Jamie215/DualIMU_Goniometer/README.md

# Dual-IMU Knee Goniometer

Two Arduino Nano 33 BLE Rev2 boards (one on the thigh, one on the shank) measure
knee flexion angle. Each board runs a 6-DOF orientation filter; the **shank
board (peripheral)** streams its state to the **thigh board (central)** over a wired UART
link, and the central merges both segments and streams them to a PC, where
`knee_collector_uart.py` computes and logs the knee angle.

The design goal is a **placement-independent** angle: you should not have to mount
the boards in a precise, repeatable orientation.

## Getting started

**Using the device (collecting data).** Download `KneeGoniometerGUI.exe` (Windows)
from the [latest release](https://github.com/Jamie215/DualIMU_Goniometer/releases/latest)
and follow the SOP, which covers building the device, flashing the boards, placing
the sensors and running a session:
[`docs/SOP_Build_and_Use.docx`](docs/SOP_Build_and_Use.docx) (master copy;
a read-only Markdown mirror is [`docs/SOP_Build_and_Use.md`](docs/SOP_Build_and_Use.md)).
No Python is needed.

**Changing the code.**
- GUI / angle math (Python): set up Python as in [Live GUI](#live-gui-knee_guipy),
  then publish a new exe as in [Releasing an updated GUI](#releasing-an-updated-gui).
- Firmware: see [Quick start](#quick-start-developers-command-line) and the
  [wire protocol](#data-format--wire-protocol); reflash **both** boards after a change.

**Background.** [`docs/Project_Handover.md`](docs/Project_Handover.md) (current state,
open issues and next steps; why it is built this way; research directions), and the
Preliminary Stationary Test Report
(`analysis/static_test/Static_Stability_Test_Report.docx`).

---

## Hardware & wiring

- 2× **Arduino Nano 33 BLE Rev2** (onboard **BMI270** accel+gyro; BMM150
  magnetometer is present but **unused**).
- UART between the boards (`Serial1`, **115200 baud**), **both directions wired**:
  the peripheral streams data to the central, and the central sends a keepalive to the
  peripheral so it only runs during a collection (see "Collect-on-demand" below):

  ```
  Peripheral TX (D1)  ->  Central RX (D0)     # shank data stream
  Central TX (D1) ->  Peripheral RX (D0)      # keepalive / start-stop
  Peripheral GND     <->  Central GND
  ```
- Central connects to the PC over USB.
- Mount convention used in testing: board long axis along the limb long axis,
  USB port toward the hip, one board above and one below the knee. Exact rotation
  / position does **not** need to match between boards (see "How it works").

---

## Quick start (developers, command line)

For data collection, use the GUI (see [Getting started](#getting-started)); this
section is the command-line route used during development.

1. **Flash** `central_imu/central_imu.ino` to the thigh board and
   `peripheral_imu/peripheral_imu.ino` to the shank board (Arduino IDE, board = "Arduino
   Nano 33 BLE", library **Arduino_BMI270_BMM150**). Confirm each reports
   *Done uploading*.
2. When a collection starts (the central's USB port is opened by the collector or
   GUI), **keep both boards still for ~4 s** — they measure gyro bias then. The
   central prints `# central gyro bias dps: ...`.
3. **Sanity check** the link and signal:
   ```
   python knee_collector_uart.py --port /dev/ttyACM0 --monitor
   ```
   `thigh` / `shank` are the gyro-fused gravity tilts the angle uses; `accel` is
   a filter-free raw-accel cross-check; `rel` is the yaw-prone relative-quaternion
   angle (drift probe); `valid%` / `rtt` show link health.
4. **Collect**:
   ```
   python knee_collector_uart.py --port /dev/ttyACM0
   ```
   - Hold the leg **straight and still** (~2 s) to zero.
   - Do a few slow reps that bend **both knee and hip** (sit-to-stands /
     marching) so each board tilts enough to learn its "forward" direction.
   - The signed knee angle is printed live and logged to `knee_log.csv`.

`--selftest` (no hardware) runs the full math test suite.

---

## Live GUI (`knee_gui.py`)

For a testing / proof-of-concept session there is a Tkinter + Matplotlib front
end over the same angle math. It is the easiest way to run a collection. Most
users run it as the Windows executable (see [below](#windows-executable)); to run
or change it from source:

```
pip install -r requirements.txt
python knee_gui.py                 # scan for the central port and go
python knee_gui.py --simulate      # no hardware: synthetic flexing-knee source
python knee_gui.py --selftest      # headless: sample-gate + source logic
```

What it adds over the CLI:

- **Port scan** — probes each serial port for valid `D` lines and picks the
  central automatically. (Only the central is on USB; a dead peripheral link shows up
  as a low shank-valid %, not a second port.)
- **One row per sample** — every data line from the central becomes exactly one
  CSV row and plot point: nothing repeated, nothing skipped. `t_session_s` comes
  from the board's own clock (true measurement timing, ~20 ms apart at 50 Hz);
  `t_wall_iso` is when the PC received the line. (Earlier versions wrote rows on a
  PC-side 20 ms timer, which repeated ~20 % of samples and skipped others.)
- **Obvious calibration** — a colour-coded banner drives the phases with a live
  countdown: amber **CALIBRATING - HOLD STILL** (straight leg) → amber
  **CALIBRATING - SWEEP** (bend knee + hip, with a live shank-tilt readout) →
  green **RUNNING** (phases `zeroing` / `sweep` / `running` in the CSV).
- **Plots** — knee angle (primary), the two segment inclinations it is built
  from, and the link RTT. While collecting they show a rolling window; when you
  **Stop collecting** they switch to the **entire session** (not just the last
  window) and a pan/zoom/save toolbar becomes usable so you can inspect the
  frozen trace (Home returns to the full-session view).
- **Dropout mode (switchable live)** —
  **Fill** forward-fills short gaps and draws a continuous line;
  **Gap** keeps only real samples and draws discrete points, so dropouts appear
  as visible gaps. The CSV records which samples were real in either mode.
- **Session-based collect / stop / reset** — each **Calibrate & collect** starts
  a fresh session: a new timestamped CSV, a cleared plot, and calibration from
  scratch. **Stop collecting** ends it, freezes the display on the last data,
  and returns to idle. Collecting again is a clean reset — you recalibrate, and
  a new file is written. (There is no pause/resume: the display only rolls while
  a session is actually collecting.)
- **Errors** — a red banner names the exact fault (no data / wrong firmware /
  dead peripheral link), using the same diagnosis as the CLI.
- **Auto-save** — each session auto-saves to `knee_YYYYMMDD_HHMMSS.csv`;
  **Save copy…** relocates the current one. A crash never loses a session.

The CSV is a superset of the CLI log (adds wall-clock and session time, the two
inclinations, and the `phase` / `fill_mode` columns), so existing analysis still
reads it.

### Windows executable

Download `KneeGoniometerGUI.exe` from the
[latest release](https://github.com/Jamie215/DualIMU_Goniometer/releases/latest).
No Python install is needed. CSVs and diag logs are written to the **current working
directory** (relative paths), which is the exe's own folder when you
double-click it, so keep the exe somewhere writable (Desktop, Documents, a
data folder), not `Program Files`. The exe is unsigned, so Windows SmartScreen
may warn on first run: **More info -> Run anyway**.

### Releasing an updated GUI

The exe is built and published by `.github/workflows/release.yml` whenever a
version tag (`v*`) is pushed: on a Windows runner it installs `requirements.txt`
and PyInstaller, runs `python knee_gui.py --selftest` (a failure stops the
release), builds the exe, and creates a GitHub Release with it attached. After
changing `knee_gui.py` or `knee_collector_uart.py` (which the GUI imports):

1. **Check locally** on your branch:
   ```
   python knee_collector_uart.py --selftest
   python knee_gui.py --selftest
   python knee_gui.py --simulate
   ```
   and, ideally, one real session with the hardware.
2. **Merge into `main`** (pull request).
3. **Pick the next version.** Never reuse a tag; `git tag --list` shows the ones
   used. Bug fix: `v1.0.1`; new feature: `v1.1.0`; a change that breaks existing
   users or analysis (e.g. CSV columns change): `v2.0.0`.
4. **Tag `main` and push the tag:**
   ```
   git checkout main
   git pull
   git tag v1.0.1
   git push origin v1.0.1
   ```
5. **Watch the Actions tab** (a few minutes). When the run is green, the
   [Releases](https://github.com/Jamie215/DualIMU_Goniometer/releases) page shows
   the new version with `KneeGoniometerGUI.exe`. Edit its notes to say what
   changed in plain words.
6. **Tell users** to download the new exe and replace their old file (SOP §4.3).

If the run fails, no release is created. Fix the problem on `main`, then push a
new tag (e.g. `v1.0.2`), or delete the failed tag and push it again:
`git push --delete origin v1.0.1`, `git tag -d v1.0.1`, then repeat step 4.

The firmware is not part of the exe. If you change the `.ino` files, reflash
**both** boards (SOP §4.2) and say so in the release notes.

"Run workflow" on the Actions tab (manual run) only builds the exe as a
downloadable artifact for testing; it does not create a release.

To build locally instead (on Windows):

```
pip install -r requirements.txt pyinstaller
pyinstaller --onefile --windowed --name KneeGoniometerGUI knee_gui.py
```

The exe is written to `dist\KneeGoniometerGUI.exe`.

---

## How it works (the math)

Each IMU estimates orientation with a **6-DOF Mahony filter** (accelerometer +
gyroscope, no magnetometer — robust to nearby metal). There is **one** angle
method, chosen for reliability across both slow and brisk motion.

### Gravity-referenced sagittal inclinometer

The reliable, observable quantity in a 6-DOF filter is the **direction of gravity
in each board's own frame**: the accelerometer pins it (so it doesn't drift in
tilt) and it's invariant to heading (so the 6-DOF yaw, which *does* drift, never
enters). We read that gravity direction from the **fused quaternion** — so the
gyro carries it smoothly through fast motion instead of the reading collapsing
whenever the limb accelerates — then build a signed segment inclination and take
the difference. Here is the full derivation.

Notation: quaternions are `(w, x, y, z)`, Hamilton convention; `q*` is the
conjugate; world "up" is `ẑ = (0, 0, 1)`. Each board `i ∈ {thigh, shank}`
reports a unit orientation quaternion `q_i` (board → world).

**1. Gravity in the board frame.** Rotate world-up into the board's own frame
with the inverse orientation, and keep the vector part:

```
g_i = vec( q_i* ⊗ (0, ẑ) ⊗ q_i ),   then normalize      # unit vector
```

`g_i` is the direction of gravity as the board feels it. It uses only the tilt
part of `q_i`, so it is **drift-free** (the accelerometer fixes tilt) and
**yaw-invariant** (rotating `q_i` about vertical leaves `g_i` unchanged). Code:
`gravity_in_board()`.

**2. Zero reference `d_i` (static-hold calibration).** With the leg held straight
and still, average `g_i` over the hold window. `d_i` is the segment's long axis
as seen in the board frame — the direction gravity points at 0°:

```
d_i = normalize( Σ g_i(t)  over the still hold )         # code: average_gravity()
```

**3. Forward direction `f_i` (functional-sweep calibration).** During the slow
reps, the part of `g_i` **perpendicular to `d_i`** is the direction the segment
tilts toward as it flexes. Remove the `d_i` component, sign-align the samples (the
limb sweeps consistently one way from extension), and sum:

```
g⊥ = g_i − (g_i · d_i) d_i                                # in-plane component
f_i = normalize( Σ sign(g⊥ · ref) · g⊥ )                  # code: estimate_forward()
```

Samples that tilt less than `SWEEP_MIN_ANGLE_DEG` are ignored so IMU noise around
the zero pose can't define the direction. `d_i` and `f_i` are orthonormal by
construction and together span that segment's **sagittal plane** in its own frame.
If a segment barely moved, `f_i` is undefined and that segment contributes 0.

**4. Signed segment inclination.** The tilt of the segment is the angle of `g_i`
within the `(d_i, f_i)` plane — the four-quadrant angle from the zero axis `d_i`
toward forward `f_i`:

```
incl_i = atan2( g_i · f_i , g_i · d_i )   [rad]           # code: sagittal_inclination()
```

At the zero pose `g_i = d_i`, so `g_i · f_i = 0`, `g_i · d_i = 1`, and
`incl_i = 0`. `atan2` gives a continuous signed angle through the full range
(flexion positive, hyperextension negative), with no ±90° wrap.

**5. Knee angle.** The joint angle is the difference of the two segment
inclinations:

```
knee = incl_thigh − incl_shank        (converted to degrees)   # code: gravity_knee_angle()
```

*Why the difference is placement-independent (sketch):* for planar flexion the
segment rotates about a fixed axis, so `g_i(t)` traces a circular arc that lies
entirely in one plane of the board frame — and a rigid mount `B_i` maps that plane
to a fixed plane spanned by `d_i, f_i`. `incl_i` reads the arc angle inside that
plane, and the fixed mount rotation only rotated the plane, not the angle within
it. So any constant mount `B_i` cancels exactly (the `--selftest` proves this
against random `B_thigh`, `B_shank`).

Because every quantity is an angle between two vectors in the **same** board
frame, the result is immune to:
- **Position** on the limb (orientation sensors don't measure location);
- **Constant mounting rotation**, incl. **rotation of the board about the leg's
  long axis** (any fixed mount rotation cancels);
- **6-DOF yaw drift** (gravity-in-board is invariant to heading about vertical).

Validated in `--selftest` against random mounts, a turning shared heading,
independent per-board yaw drift (exact recovery), and a full flex-to-130°-and-back
sweep (the signed angle retraces identically — no stuck zeros on return).

**Trade-off:** gravity gives only **2 of the 3 rotational DOF** — it is blind to
rotation about the vertical (gravity) axis. So this method measures the
**sagittal-plane** component of the angle — ideal for upright knee flexion
(standing ROM, gait, sit-to-stand). It under-reads motion well out of the vertical
plane (e.g. lying down with large hip rotation). Note this is an *observability*
limit, not a mounting one: a fixed mount tilt cancels for planar motion (step 5),
but tilt combined with out-of-sagittal-plane motion steers part of the true joint
rotation into the unobservable yaw direction, where gravity cannot see it — the
one case a gravity-only method fundamentally cannot recover.

### What "0°" means (relative, not absolute)

The angle is **relative to the pose held during the static zero** — whatever
posture you hold at calibration becomes 0°, regardless of the true anatomical
geometry. A leg that is anatomically straight but sits at a residual angle
(recurvatum, or a patient who can't fully extend) still reads **0°** here. Every
reading is therefore a **change from the zeroing pose**, not an absolute
femur-vs-tibia angle.

This is exactly right for what a session actually measures — **ROM (max − min),
rep counting, gait, and movement quality** are all difference-based, so the
reference cancels and the choice of zero doesn't matter. What it does **not**
give:

- an **absolute clinical angle** (e.g. "flexion contracture of 10°"), which is a
  statement about the zero itself;
- comparability **across sessions** zeroed on different poses, since each
  session's 0° may correspond to a different real angle.

Recovering a true anatomical zero would require an **external reference** — a
manual goniometer on the leg, or a fixture that physically defines full
extension. The two IMUs alone cannot observe it: the method is deliberately blind
to how each board is mounted relative to the bone (that blindness is exactly what
makes it placement-independent), so there is no anatomical landmark in the data
for it to find absolute zero from. For this proof of concept we accept the
relative zero and rely on the difference-based readings above.

### Why the quaternion (not the raw accelerometer)

Gravity-in-board is taken from the Mahony quaternion, which fuses accel + gyro,
rather than from the bare accelerometer. During any brisk movement the raw
accelerometer measures gravity **plus linear acceleration**, so its direction is
momentarily wrong — the cause of erratic readings (and apparent zeros) right after
swinging back from a high angle. The fused quaternion lets the **gyro carry** the
fast part while the accelerometer keeps the tilt drift-free, so the angle stays
smooth *and* drift-free. The firmware trusts the accelerometer with a **soft
gate** (`ACC_TRUST_FULL_G` → `ACC_TRUST_ZERO_G`): full weight when near-static,
ramping to zero as `|accel|` leaves 1 g — always applying *some* correction, so
the estimate never runs fully open-loop and then snaps back.

(The raw accelerometer is still streamed and shown as a filter-free cross-check in
`--monitor`.)

---

## Commands

```
python knee_collector_uart.py --port PORT [options]

  --monitor                 live bring-up check (gyro-fused vs raw-accel tilts)
  --raw                     dump raw serial lines with field counts, then exit
  --cal-seconds N           straight-and-still zero hold (default 2)
  --sweep-seconds N         calibration-motion window (default 6)
  --out FILE                CSV path (default knee_log.csv)
  --selftest                run the math self-tests (no hardware)
```

CSV columns: `t_thigh_us, thigh_qw..qz, shank_qw..qz, knee_angle_deg, status,
rtt_us` (status ∈ `zeroing / sweep / valid / filled / missing`).

---

## Data format / wire protocol

**Peripheral → central stream (binary, 30 bytes/packet, fixed 50 Hz):**
```
[0]      0xAA header
[1..16]  float q0..q3   (little-endian, w,x,y,z)
[17..28] float ax,ay,az (little-endian, g, handedness-corrected)
[29]     XOR checksum of bytes [1..28]
```
**Collect-on-demand & rate.** The boards run their IMUs only while a collection is
active, so nothing runs unobserved. "Active" = the central's **USB port is open** (the
collector, GUI, or even the Serial Monitor holds it) — no PC-side command needed. On
start the central calibrates + seeds fresh and forwards a **keepalive** to the peripheral
(over `Central TX -> Peripheral RX`); the peripheral calibrates and streams while the keepalive
arrives and idles when it stops (port closed / central reset). Both boards emit at a
fixed **50 Hz** (down from ~104 Hz) for generous link + USB timing margin; the peripheral
also self-heals a bad low-rate sensor start by re-initializing (no manual reset).
It also guards against a failing sensor: a sample with a hung read (> 50 ms),
an impossible |accel| (< 0.25 g or > 4 g), or a rotation rate over 1000 °/s while
the accelerometer reads ~1 g is never fed to the filter and is sent as the all-zero
quaternion (a gap, not a wrong angle); every re-init resets the filter's integral
term; and if no good sample arrives for 5 s the peripheral reboots itself. LED:
central lit = collecting; peripheral fast blink = active, slow blink = idle, solid = sensor
stalled, 3 flashes = boot.

The shank board **streams** its packets while active; it is not polled. The central is
a passive listener on the data line: each loop it drains its UART buffer, **resyncs on the `0xAA`
header**, validates the checksum, and keeps the freshest complete packet — it never
blocks on the peripheral. A lost/extra byte fails one checksum and resyncs on the next
header, so a glitch costs one packet, never a lasting desync. The central timestamps
each packet on its own clock when parsed; if the freshest packet is older than
`SHANK_STALE_US` (30 ms) the shank is reported invalid (zeros) for the collector to
forward-fill. The line's last field is that packet's **age** in µs — small is
healthy, large (or a run of invalids) means the peripheral has stalled.

**Central → PC line (text, 18 fields):**
```
D,t_thigh_us,tw,tx,ty,tz,tax,tay,taz,t_shank_recv_us,sw,sx,sy,sz,sax,say,saz,age_us
```
When the freshest shank packet is stale/absent, `t_shank_recv_us` and the shank
fields are `0`; the collector marks such samples invalid (and short gaps are
forward-filled). `age_us` is the freshest shank packet's age (the CSV keeps the
`rtt_us` column name for continuity — same units, a link-health number).

**Diagnostics (`DIAG 1` in both sketches).** The peripheral also sends a once-a-second
health frame on the same link (`0xAB` header, packed `PDiag` struct, XOR checksum;
the struct must match in both files). The central relays it to the PC as
`# PDIAG k=v ...` and adds its own `# CDIAG k=v ...` line (emit interval, IMU-read
and print durations, parser counters, UART backlog, IMU health). `knee_gui.py`
saves every `#` line to `knee_diag_<timestamp>.log`, and
`analysis/diagnostics/parse_diag.py <log>` turns it into per-second CSVs and a
per-minute summary. Flash **both** boards with a diagnostic build: an older central
doesn't know the `0xAB` frame and can lose a shank packet a second resyncing.
The GUI CSV also carries the raw accelerometer of each board
(`thigh_ax..az`, `shank_ax..az`, g), which shows physical movement independent of
the orientation filter.

---

## Findings / debugging log

The path to a stable signal turned up several non-obvious issues, all worth
recording:

1. **The Arduino library returns a left-handed sensor frame.**
   `Arduino_BMI270_BMM150` maps `x=-sensor.y, y=-sensor.x, z=sensor.z` for both
   accel and gyro — **determinant −1, a reflection**. A quaternion filter needs a
   right-handed frame (angular velocity is an axial vector), so the gyro's
   rotation sense was mirrored relative to the accelerometer and the filter
   wandered. **Fix:** negate `x` of accel *and* gyro to restore det +1.

2. **Startup gyro-bias calibration can cause runaway.** Averaging the gyro at
   boot to subtract bias is only valid if the board is still; if it's moving, the
   subtracted "bias" is a large false rate that can exceed the filter's
   correction gain and make the estimate diverge. **Fix:** discard the measured
   bias if any axis exceeds `BIAS_SANITY_DPS` (3 °/s), and keep the board still
   at startup.

3. **6-DOF has no shared heading.** Each board's yaw is unobservable and drifts
   independently, so the *relative-quaternion* angle drifts even on a rigid,
   stationary rig. The **gravity-referenced** method avoids this because
   gravity-in-board is yaw-invariant. (A rigid-ruler test — both boards on one
   ruler — was the key diagnostic: the true relative angle must be constant, so
   any drift is pure estimation error.)

4. **"Gravity from the quaternion" inherits a bad quaternion.** *While the filter
   was still wandering* (before finding #1 was fixed), both paths failed together,
   and reading gravity straight from the **raw accelerometer** was the decisive
   static fix. Once the handedness reflection was corrected the quaternion tracks
   properly, and the raw accelerometer's own weakness (finding #5) made it the
   worse default — see finding #7.

5. **Fast motion corrupts the accel-as-gravity assumption.** During any brisk
   movement the accelerometer reads gravity **plus linear acceleration**, so its
   direction is momentarily wrong. In the filter this is handled by **accel
   trust gating**; a bare-accelerometer angle has no such protection and reads
   erratically (apparent zeros/overshoot) right after swinging back from a high
   angle.

6. **Shank dropouts that grow over a session — traced in three steps.** The symptom
   was shank samples going invalid more and more as a session ran, with the link
   round-trip climbing alongside. Diagnosing it took three passes, each of which
   ruled something out:

   - **Framing desync.** The board-to-board reply was read as a fixed 30 bytes with
     no header resync, so one lost/extra byte on the async link shifted every
     following packet by one, and the misalignment was self-sustaining. **Fix:**
     resync on the `0xAA` header + validate the checksum, so a glitch costs one
     packet, not a run. Also returned `Serial1` from `460800` to **115200** for ~4×
     the per-byte timing margin (a 30-byte packet at 104 Hz needs only ~25 kbaud, so
     the lower rate costs nothing and drifts far less as the boards self-heat). An
     earlier pass had *raised* the rate to `460800` to shrink time-on-wire, which
     masked the desync but added the thermal fragility.
   - **Too-tight response window.** With framing fixed, `valid%` rose to ~93% but
     the remaining drops showed the request round-trip hitting the *full* timeout —
     the peripheral producing nothing in time, not corrupt bytes. Root cause: the peripheral
     only answered a poll between chunks of its own loop, and the mbed RTOS adds
     sporadic multi-ms stalls, so a reply could arrive after any fixed deadline.
   - **The real fix — stream instead of poll.** Widening the deadline is an arms
     race (and every stall stalls the central). Instead the peripheral now **streams** its
     packet continuously and the central reads the freshest one already in its UART
     buffer, never blocking. A peripheral stall no longer drops a sample — it just ages
     the newest packet; if that age exceeds `SHANK_STALE_US` (30 ms) the sample is
     marked invalid and the collector forward-fills it. This decouples the central's
     rate from the peripheral's latency entirely. Line field 18 is now the packet **age**
     (`age_us`); a large age or a run of invalids localizes a stalled/dead peripheral.

7. **Consolidated to one reliable method: gravity-in-board from the fused
   quaternion.** The project had accumulated four selectable behaviors
   (`--method gravity|quat` × `--gravity-source accel|quat`) that masked each
   other's failure modes. With the filter now correct (finding #1), the
   quaternion-sourced gravity direction is both **smooth through fast motion**
   (gyro carries) and **drift-free in tilt** (accel corrects) — strictly better
   than the raw-accel default, whose motion corruption (finding #5) produced the
   erratic post-flexion readings. The alternate modes and the yaw-prone
   relative-quaternion swing-twist method were removed. The hard accel gate was
   also replaced with a **soft gate** (`ACC_TRUST_FULL_G` 0.10 g →
   `ACC_TRUST_ZERO_G` 0.60 g): trust ramps down with `|accel|` instead of cutting
   off, so the filter is always partly corrected during motion and never runs
   open-loop and then snaps back on the way out.

Validation so far: on a rigid ruler, thigh and shank tilts agree; placing the
shank board at a right angle to the thigh board reads ~90°.

> Note: an earlier exploration added a full **magnetometer (9-DOF)** path with
> runtime PC-side calibration and an automatic BMM150→BMI270 axis solver. It was
> removed in favor of the simpler, metal-robust 6-DOF + gravity approach, but it
> lives in the branch history if absolute-heading stability is ever needed.

---

## Known limitations & next steps

- **Sagittal plane only** — see the trade-off above.
- **Validate against a protractor** — a preliminary 45°/90° rig check read
  45.0° / 89.0° (see the stationary test report); a controlled, repeated test
  with **both** nodes swept during calibration is still needed.
- **Faulty board** — one board's BMI270 fails after 20–40 min; replace it before
  further testing (see `docs/Project_Handover.md`).
- **Fast dynamic capture** — the gyro-fused gravity direction carries through
  motion; if very fast reps still lag or overshoot, tune the filter (`TWO_KP`)
  and the soft gate (`ACC_TRUST_FULL_G` / `ACC_TRUST_ZERO_G`) on both boards.
- **Per-session re-zero** handles any slow accelerometer/bias offset; hold the
  leg straight and still at the start of each capture.
- **Dropouts** — watch the run summary (`valid / filled / missing`); if the link
  is flaky over long wires, drop `Serial1` to 230400 on both boards.

For larger research directions being weighed — magnetometer fusion and the
absolute-vs-relative angle question, absolute (anatomical) angle via functional
calibration, wireless (BLE) links, and scaling to multiple nodes / joints — see the appendices of
[`docs/Project_Handover.md`](docs/Project_Handover.md).

---

## Files

```
central_imu/central_imu.ino          thigh board: 6-DOF filter, reads peripheral stream, streams to PC
peripheral_imu/peripheral_imu.ino    shank board: 6-DOF filter, streams packets over UART
knee_collector_uart.py               PC collector: calibration, angle math, CSV, --selftest
knee_gui.py                          live GUI over the same math: guided calibration, plots, auto-save
requirements.txt                     Python dependencies (collection, GUI, analysis)
DualIMU_Goniometer.stl               3-D printable board case (base + lid)
analysis/static_test/                stationary test scripts, figures, report (.docx) and FINDINGS.md
analysis/diagnostics/parse_diag.py   diag log (# CDIAG / # PDIAG lines) -> CSVs + per-minute summary
docs/SOP_Build_and_Use.docx          SOP: build, set up and run the device (Word master; .md mirror)
docs/Project_Handover.md             handover: state and next steps, design decisions, research directions (+ .docx)
docs/build_docs.sh                   regenerates Project_Handover.docx from its Markdown (pandoc)
docs/images/                         figures for the SOP mirror (sop/) and the handover document (handover/, SVG sources)
.github/workflows/release.yml        builds and releases KneeGoniometerGUI.exe on a v* tag
```
