Jamie215/DualIMU_Goniometer/analysis/static_test/report_stability.png

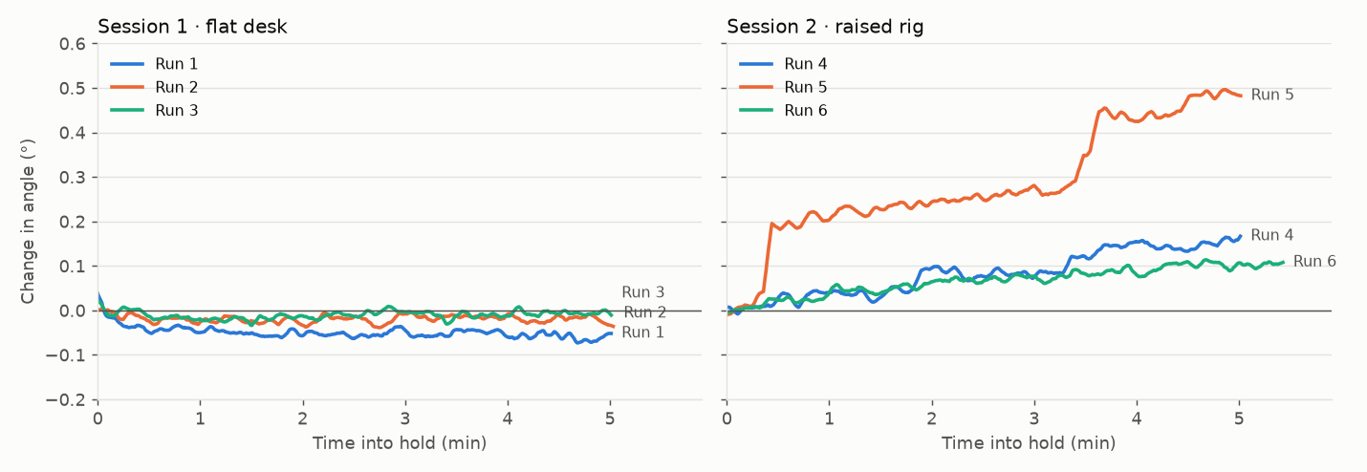
analysis/static_test/report_stability.png
