Jamie215/DualIMU_Goniometer/DualIMU_Goniometer.step

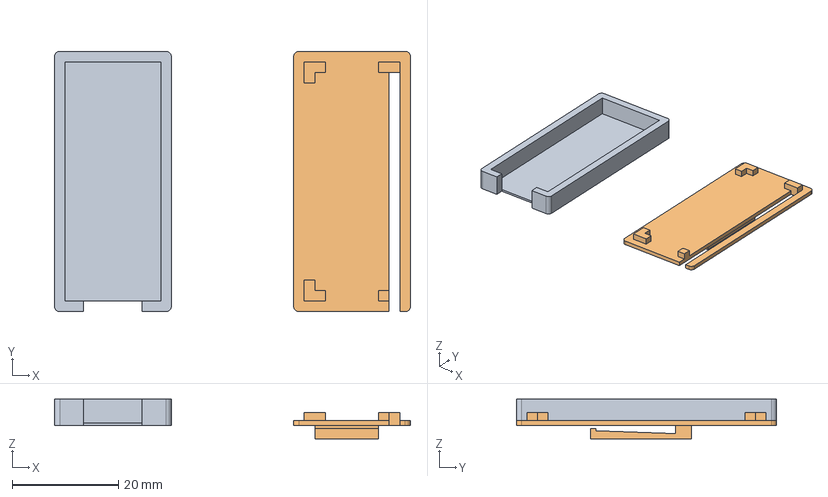
[picture p6: CAD file, 2026-10-29]
DualIMU_Goniometer.step
67.0 x 49.0 x 7.50 mm
