Jamie215/DualIMU_Goniometer/(list of files, cad)

Other CAD files:
DualIMU_Goniometer.stl
