Jamie215/DualIMU_Goniometer/analysis/static_test/Static_Stability_Test_Report.docx

# Dual-IMU Goniometer Project

Preliminary Stationary Test Report

This document records the stationary testing of the dual-IMU goniometer prototype: what was tested, how, what the results showed, which problems turned up along the way and how they were addressed.

# What We are Testing

- Stability: Given there is no range of motion, does the measured angle also stay unchanged? This test covers short-term jitter, slow drift, and data quality over sessions.
- Endurance: How long can the data be collected without data quality dropping?
- Preliminary angle check: Do fixed 45° and 90° rigs read close to nominal? This is a preliminary inspection only, as the environment did not allow a fully controlled setup.

# Setup

Hardware: Two Arduino Nano 33 BLE Rev2 boards (BMI270 IMU) connected by a wired UART link; both nodes were powered over USB.

| Session 1 (Runs 1–3) | Session 2 (Runs 4–6) | Endurance Runs 1–3 | Angle Rig (45°, 90°)
Thigh node | Taped to the desk | Taped to a raised rig (1 cm higher) | Taped to the rig | On the flat upper segment
Shank node | Taped to a ruler | Taped to a flat surface (~5 cm apart) | Taped to a ruler | On the angled lower segment
Duration | ~5 min per run | ~5–5.5 min per run | 24–60 min, unattended | ~20–25 s hold each

Procedure (every run):

1. Zeroing (2 seconds): Both nodes held still. This pose becomes 0°.
2. Calibration sweep (6 seconds): The shank node was rotated and returned, so the software learns the direction it bends in.
3. Collection: For testing purposes, the nodes were stationary through this phase. For the angle rig, the shank segment was set at the rig angle and held.

Note: The first 20 seconds (time taken for calibration and settling) are excluded from the stability analysis.

# Findings

## 1. Sessions 1 & 2: Near-Zero Angle Stability

Change in angle during each 5-minute hold

Figure 1: Change in the measured angle during each stationary hold (5 s rolling average), relative to the first 10 s of the hold

Table 1: Stationary hold results for Sessions 1 and 2

Run | Resting angle | Jitter (SD) | Change over the Hold | Drift
1 | −0.30° | 0.015° | −0.06° | −0.005 °/min
2 | −0.02° | 0.011° | −0.03° | −0.0003 °/min
3 | +0.03° | 0.011° | −0.01° | +0.001 °/min
4 | +6.38° | 0.016°∗ | +0.16° | +0.033 °/min
5 | −1.27° | 0.047°∗ | +0.49° (two steps) | +0.082 °/min
6 | −0.84° | 0.012°∗ | +0.11° | +0.019 °/min

∗ Note 1: The resting angle is where the node came to rest after the calibration sweep, relative to where it was zeroed. It reflects placement and stays constant during the hold.

∗ Note 2: For Session 2, the SD is calculated with the slow trend removed, so it measures jitter rather than creep.

Table 2: Allan deviation (how much averages over a time window τ differ from one window to the next)

Averaging Window τ | Session 1 | Session 2
0.1 s | 0.003° | 0.003°
1 s | 0.005° | 0.005–0.007°
60 s | 0.004–0.007° | — (rig creep dominates)

- Session 1
  - The reading moved by 0.06° at most over 5 minutes, and the drift direction flipped between runs, indicating noise rather than drift.
  - The Allan deviation shows that the noise did not grow over time.
- Session 2
  - The reading crept by 0.1–0.5°.
  - Run 5 had two sudden steps. The thigh node, which is not part of the angle calculation, moved at the same time, so the creep most likely came from the setup settling. In a later run, the raw accelerometer confirmed that a similar creep was the ruler physically tilting.

## 2. Endurance Test

Three unattended endurance runs of 24–60 minutes checked how long data can be collected before its quality drops.

Table 3: Endurance runs

Run | Faulty board’s role | Length | Clean data until (board uptime) | Outcome
1 | Shank | 38 min | 20.4 min | Shank sensor degraded, then stopped at 26.3 min; no shank data afterwards
2 | Shank | 24 min | 24.8 min | Shank sensor failed abruptly; the board rebooted itself, but the sensor stayed dead
3 (roles swapped) | Thigh | 60 min | 37.8 min | Thigh sensor stopped at 47.3 min and sampling fell to ~5 Hz

∗ Note 3: Board uptime is the board’s own clock since power-up. The cause of the faults is covered in Issues Found (2).

Table 4: Angle stability during the clean part of the endurance runs

Run | Window | Length | Jitter (SD) | Drift | Range of 5 s averages
1 | 3–18 min | 15 min | 0.016° | −0.001 °/min | 0.10°
3∗ | 3–36 min | 33 min | 0.018° | −0.001 °/min | 0.09°

∗ Note 4: In endurance run 3, the angle came only from the healthy shank board, since the thigh node is not part of the angle (see Limitations). The window ends before the thigh node’s sensor fault affected the data flow.

- Endurance
  - On the faulty board, data quality dropped after 20–38 minutes in every run, while the other board ran for over an hour without a fault in either role.
  - The drop in quality after long sessions is traced to that board (see Issues Found (2)).
- Stability over time
  - Over the clean windows, the angle drifted about −0.001 °/min (about 0.04° over 33 minutes), with the same jitter as the 5-minute holds.

## 3. Preliminary Angle Assessment: 45° and 90°

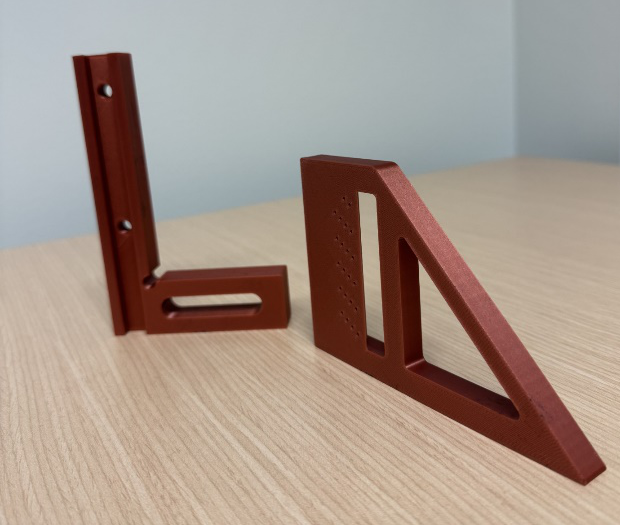
[picture p12: figure]

Figure 2: Angled rigs used during the test (left: upper segment, right: lower segment)

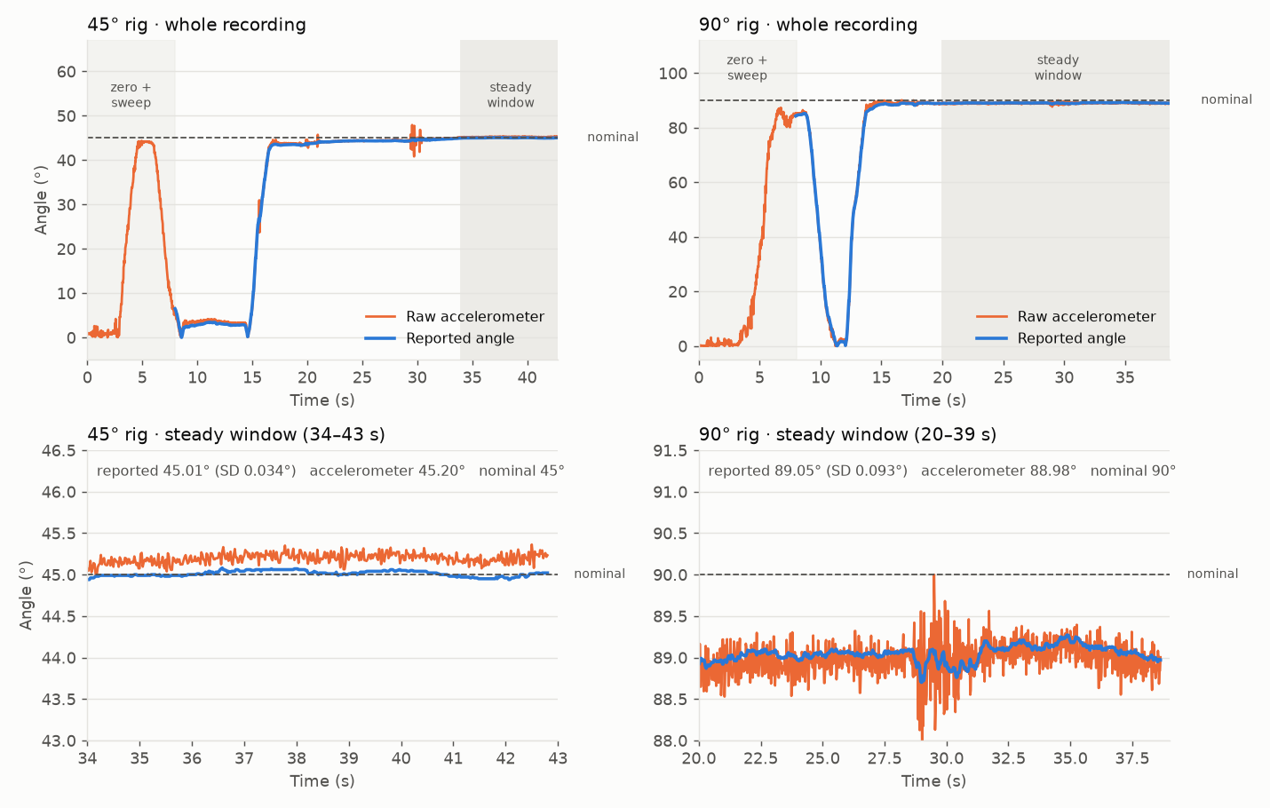
[picture p13: figure]

Figure 3: Static angle collected over time (45° and 90°)

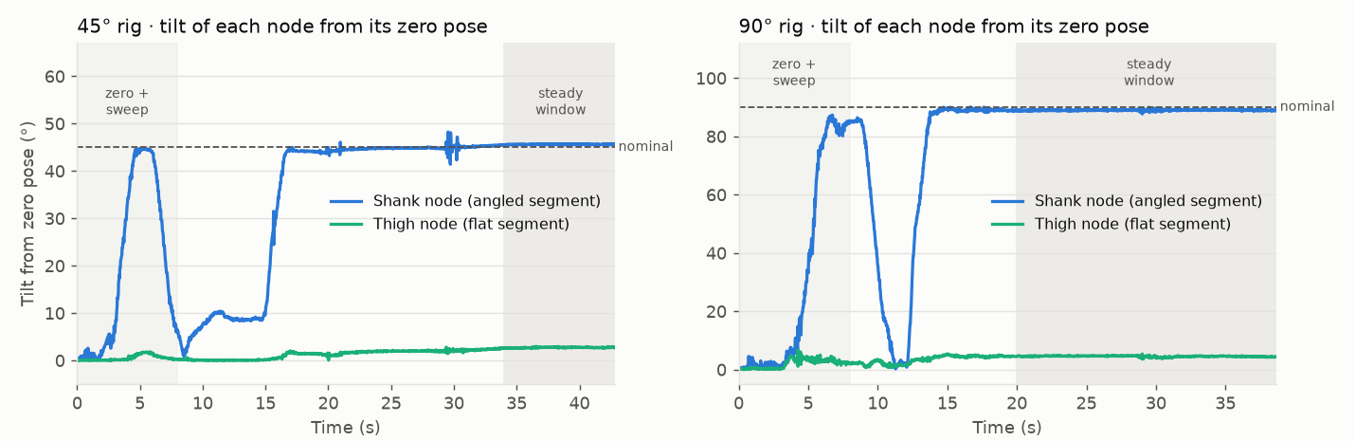
[picture p14: figure]

Figure 4: Tilt of each node over time (45° and 90°)

∗ Note 5: These are from raw accelerometers, measured from its own zero pose, which is different from how the angle (range of motion) is calculated in the software. This is to inspect if the there was any movement at the node level.

Table 5: Static angle assessment (45° and 90°)

Rig | Reading (steady part) | Diff from nominal | Jitter (SD) | Raw-accelerometer check
45° | 45.0° | 0.0° | 0.034° | 45.2°
90° | 89.0° | 1.0° | 0.093° | 89.0°

- Shank node tilt is measured correctly
  - The raw accelerometer, which does not depend on the filter or the calibration, agrees with the reported angle within about 0.2°. The calibration therefore learned the right bending direction, and a 90° hold is as steady as a 0° hold.
- Reference (thigh) node shifted during placement
  - The thigh node shifted 2.7° on the 45° rig and 4.5° on the 90° rig. It tilted about as much across the bending plane as along it, which suggests the board shifted on its segment rather than the segment rotating.
  - The software ignores this node because it did not tilt during calibration. If the upper segment stayed flat, as intended, the readings above stand; if the segment itself moved, the true angle between the segments could differ by up to ~2–3°.

## 4. Other Notable Findings

- Heading drift does not affect the angle
  - Each sensor’s heading (compass direction) drifted by 0.2–5 °/min, and the angle ignored it in every run, by design.
- Calibration copes with an imperfect setup
  - In Session 2, the shank node was zeroed 4–15° off level, and the sweep was shorter (~55°) and in the opposite direction. Calibration still worked and the reading was just as steady.
  - These holds stayed within the swept range. By design, the angle depends only on the sweep’s direction, not on how far it went; the rig tests held slightly beyond their sweeps (45.0° vs 44.3°, 89.0° vs 85.5°) with no loss of agreement, but holding well beyond a short sweep was not tested.
- Link reliability
  - All samples were valid in the six short runs (Session 1 & 2). The endurance runs had no checksum failures while the boards were healthy, apart from 2 at start-up in one run.

# Issues Found

## 1. Sample Rate was ~40 Hz (Fixed)

Table 6: Sample rate before and after the fixes

| Before | After the fixes
Central board’s cycle | ~23 ms (~43.5 Hz) | 20.0 ms (50 Hz)
Printing each data line | ~11.7 ms (~36 separate prints) | ~1.0–1.8 ms (one write)
Unique samples in the CSV | ~40.5 per second | ~50 per second
CSV rows repeating the previous sample | 19–20 % | 0 %

- Cause
  - The central board ran slow: each output cycle spent ~10.7 ms reading its IMU and ~11.7 ms printing the data line as ~36 separate blocking prints.
  - The interface wrote rows on its own 20 ms timer, which ticks unevenly on Windows, so rows repeated some samples and skipped others.
- Fixes
  - The central board builds each line in memory and sends it with one write.
  - The interface now writes exactly one row per received sample, timed by the board’s own clock.
  - Both were confirmed in the endurance runs: 50 rows/s, 0 duplicate rows, rows 19.9 ms apart.
- Effect on the results above
  - None for the stationary results: with duplicates removed, every run’s mean, SD and drift are identical to within 0.0002°. The fix matters for movement data.

## 2. Poor Data Quality in Long Sessions (Traced to One Faulty Board)

During the endurance runs, data quality from one node dropped after 20–38 minutes, and its sensor stopped after 25–47 minutes. The evidence points to a hardware fault on one of the two Arduino boards as the most likely cause.

Table 7: Sensor fault timeline for the faulty board

Endurance run | Faulty board’s role | Sensor trouble started | Sensor stopped
1 | Shank | 20.4 min | 26.3 min
2 | Shank | 24.8 min (abrupt) | 24.8 min; still dead after the automatic reboot
3 (roles swapped) | Thigh | 6.5 min (missed updates); 37.8 min (hung reads) | 47.3 min

- What happened
  - Individual sensor reads started hanging for ~190–200 ms and returning garbage while the board sat still (accelerometer up to 4.4 g, gyro up to 2400 °/s), which made the angle swing by tens of degrees.
  - A few minutes later the sensor stopped producing data entirely. Restarting the sensor, or rebooting the board, did not bring it back.
- How it was traced
  - Swapping the boards’ firmware roles moved the fault with the board: the failing board failed again as the thigh node, while the other board ran the shank role for over an hour with 0 bad readings.
  - Across all runs, the other board never had a sensor problem in either role.
- Mitigation added
  - The shank firmware rejects implausible sensor samples and records them as gaps instead of wrong angles, resets its filter after each sensor restart, and reboots the board if the sensor produces nothing usable for 5 seconds.
  - During the endurance test #2, the guard caught the bad readings which triggered the reboot. However, the sensor stayed dead, which is further evidence that the fault was in the hardware.

# Limitations

- Only one node was exercised in the angle
  - The angle is the difference between the two nodes’ tilts, but the software only uses a node’s tilt if it moved at least 5° during the calibration sweep. For the tests conducted in this report, only the shank node was swept, so the thigh node was treated as fixed and the angle came from the shank node alone.
  - The thigh node’s own data shows it was just as stable, but its contribution to the angle was not tested.
- Accuracy needs to be further assessed in a fully controlled environment
  - The 45°/90° check was one placement each, and the thigh node shifted 2.7–4.5° during placement.
- Jitter is limited by the log format
  - Angles are logged to 0.01°, so the ~0.01° jitter is an upper bound; the true sensor noise can be lower.

# Conclusions and Next Steps

Across short stationary holds, endurance tests, and a preliminary 45°/90° rig check, the prototype held a very stable angle on healthy hardware (≈0.01–0.02° jitter, ≈−0.001 °/min drift) and read within about 1° of both rig angles. Testing also revealed a sample-rate shortfall, now fixed to a true 50 Hz, and traced the loss of data quality in long sessions to a faulty sensor on one Arduino board, with firmware added to contain it. Accuracy remains preliminary, but the results support moving on to both-node calibration and dynamic range-of-motion testing once the faulty board is replaced.

Next steps include first replace the faulty board and repeat a one-hour stationary run on two healthy boards to establish a clean baseline. From there, both nodes should be swept during calibration so that the angle uses both sensors, and the reference node and its cable should be fixed firmly so they cannot shift. If a more precise rig is available, repeating the 0°, 45° and 90° placements several times each would turn the angle check into an accuracy figure. Logging angles to more decimal places would reveal the true noise floor, and with the sample rate and CSV timing now sound, the work can move on to dynamic range-of-motion testing.
