Jamie215/DualIMU_Goniometer/analysis/static_test/angle_rig_nodes.png

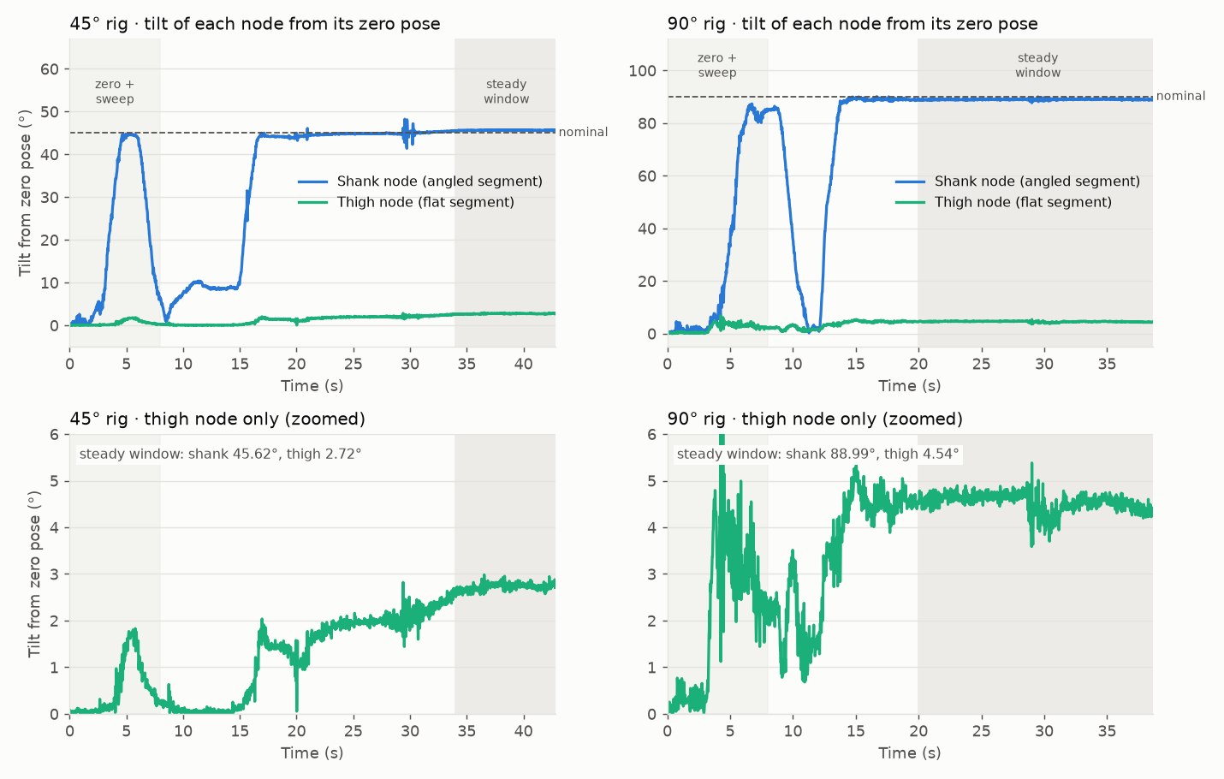
analysis/static_test/angle_rig_nodes.png
