Jamie215/DualIMU_Goniometer/central_imu/central_imu.ino

/*
 * KNEE ANGLE - CENTRAL (thigh)  [UART, 6-DOF quaternion + raw gravity]
 * Board: Arduino Nano 33 BLE Rev2  (onboard BMI270; magnetometer unused)
 *
 * Streams, per segment: an orientation quaternion (6-DOF Mahony) AND the raw
 * accelerometer vector. The collector derives the knee angle from the gravity
 * direction in each board's own frame, taken from the QUATERNION (gyro-fused,
 * so it stays smooth through fast motion and drift-free in tilt). The raw accel
 * is still sent for the filter-free cross-check in --monitor.
 *
 * IMPORTANT axis note: Arduino_BMI270_BMM150 returns accel/gyro as
 *   x=-sensor.y, y=-sensor.x, z=sensor.z  (determinant -1, a REFLECTION -> a
 * left-handed frame). A quaternion filter needs a right-handed frame, so we
 * negate x of accel AND gyro to restore det +1. Without this the gyro's rotation
 * sense is mirrored vs the accel and the filter wanders.
 *
 * The shank board STREAMS its state at a fixed 50 Hz; this board is a passive
 * listener. Each loop it drains its UART buffer, keeping the freshest complete
 * packet, and emits a merged PC line at 50 Hz -- it never blocks waiting on the
 * peripheral, so a peripheral stall just ages the last packet instead of dropping a sample.
 * The lower rate (down from ~104 Hz) leaves generous link + USB timing margin.
 *
 * Peripheral stream packet (30 bytes):
 *   [0] 0xAA header
 *   [1..16]  float q0..q3        (LE, w,x,y,z)
 *   [17..28] float ax,ay,az      (LE, g, handedness-corrected)
 *   [29] XOR checksum of [1..28]
 *
 * PC line (18 fields):
 *   D,t_thigh_us,tw,tx,ty,tz,tax,tay,taz,t_shank_recv_us,sw,sx,sy,sz,sax,say,saz,age_us
 * The last field is the freshest shank packet's AGE in us (0 if none yet). When the
 * newest packet is older than SHANK_STALE_US the shank fields and its timestamp are
 * 0, so the collector marks the sample invalid and forward-fills it.
 *
 * Collect-on-demand: the boards run their IMUs only while a collection is active
 * (this board's USB port is open). The central forwards a keepalive to the peripheral so
 * both run in lockstep and both idle when the port closes -- nothing runs unobserved.
 *
 * Wiring (BOTH directions needed): Peripheral TX(D1)->Central RX(D0) for the stream, and
 * Central TX(D1)->Peripheral RX(D0) for the keepalive, plus GND<->GND.
 *
 * DIAGNOSTICS (DIAG = 1): once a second this board prints a '# CDIAG ...' line
 * (its own loop/emit timing, link-parser counters, thigh IMU health) and relays
 * the peripheral's once-a-second health frame as '# PDIAG ...'. Both are
 * space-separated key=value lines; the collector and GUI ignore '#' lines for
 * data, and the GUI saves them to a knee_diag_*.log file next to the CSVs.
 * Peripheral health frame (sizeof(PDiag) + 2 bytes):
 *   [0] 0xAB header, [1..N] PDiag struct (LE, packed), [N+1] XOR of [1..N]
 * Flash BOTH boards with a diagnostic build: an older central doesn't know the
 * 0xAB frame and may lose a shank packet each second to resyncing.
 */

#include "Arduino_BMI270_BMM150.h"

const float TWO_KP = 2.0f * 0.5f;
const float TWO_KI = 2.0f * 0.02f;
float integralFBx = 0.0f, integralFBy = 0.0f, integralFBz = 0.0f;
float q0 = 1.0f, q1 = 0.0f, q2 = 0.0f, q3 = 0.0f;
unsigned long lastMicros = 0;

// Resting gyro bias (deg/s), measured at startup. Guarded: if the board wasn't
// still (measured bias too large), we discard it rather than inject a false rate.
float gyroBias[3] = {0.0f, 0.0f, 0.0f};
const float BIAS_SANITY_DPS = 3.0f;

// Accelerometer-as-gravity trust, as a function of how far |accel| is from 1 g.
// A hard on/off gate let the filter run gyro-only through a fast move, so it
// drifted and then snapped back on the way out (the "wrong reading right after
// returning from a big angle" symptom). Instead we SOFT-gate: full accel trust
// when nearly static, ramping linearly to zero as linear acceleration grows, so
// some drift correction is always applied while the gyro carries the fast part.
const float ACC_TRUST_FULL_G = 0.10f;   // within this of 1 g -> trust accel fully
const float ACC_TRUST_ZERO_G = 0.60f;   // beyond this -> gyro only (no correction)

// The shank streams a packet every ~20 ms (50 Hz). We treat the newest packet as a
// live shank sample until it is older than this; past it, the peripheral is presumed
// stalled and the sample is emitted invalid for the collector to fill. 30 ms is ~1.5
// packet intervals: it absorbs normal phase jitter without lying about the data
// (shank orientation barely moves in 30 ms), while flagging a dead peripheral promptly.
const unsigned long SHANK_STALE_US = 30000;

// Fixed PC output rate (the 50 Hz baseline). The filters still run at the sensor's
// full rate for smoothness, but we emit ONE merged line every EMIT_PERIOD_US. A
// lower collection rate halves link + USB pressure and leaves generous timing
// margin, and 50 Hz is far more than knee ROM needs (it's resampled PC-side anyway).
const unsigned long EMIT_PERIOD_US = 20000;   // 50 Hz
unsigned long lastEmitUs = 0;
float thighAx = 0, thighAy = 0, thighAz = 1;  // latest thigh raw accel, cached for the emit

// --------------------------------------------------------------------------- //
// Diagnostics. Set DIAG to 0 to drop the '#' lines (the 0xAB frame is still
// parsed, harmlessly, if a diagnostic peripheral is attached).
// --------------------------------------------------------------------------- //
#define DIAG 1
const unsigned long DIAG_PERIOD_MS = 1000;

// Peripheral health frame -- MUST match peripheral_imu.ino byte for byte.
struct __attribute__((packed)) PDiag {
  uint32_t upMs;          // peripheral millis()
  uint16_t pktsSent;      // shank packets sent this window
  uint16_t keepalives;    // 'S' bytes received this window
  uint16_t rateReinits;   // cumulative low-rate watchdog re-inits
  uint16_t stallReinits;  // cumulative stall watchdog re-inits
  uint16_t beginFails;    // cumulative IMU.begin() failures
  uint16_t lastReinitMs;  // duration of the most recent re-init
  uint32_t loopMaxUs;     // longest loop() pass this window
  uint32_t sendLateMaxUs; // worst lateness of a send vs its 20 ms due time
  uint32_t sendLateAvgUs; // mean lateness
  int16_t  gyroMaxDps;    // max |gyro| (bias-corrected), deg/s
  int16_t  gyroAvgDps10;  // mean |gyro|, 0.1 deg/s
  int16_t  accMinMg;      // min |accel|, milli-g
  int16_t  accMaxMg;      // max |accel|, milli-g
  int16_t  integDps10;    // |Mahony integral term| now, 0.1 deg/s
  int16_t  biasDps100;    // largest axis of the last bias measurement, 0.01 deg/s
  uint16_t badSamples;    // samples rejected by the sensor-fault guard this window
  uint16_t readMaxMs;     // slowest accel+gyro read this window, ms
  uint8_t  biasOk;        // 1 = last bias measurement accepted (board was still)
  uint8_t  active;
};
const uint8_t HDR_SHANK = 0xAA;
const uint8_t HDR_PDIAG = 0xAB;
const int SHANK_FRAME_LEN = 30;
const int PDIAG_FRAME_LEN = sizeof(PDiag) + 2;
PDiag pdiag;
bool pdiagFresh = false;

// Central-side window counters (reset every DIAG_PERIOD_MS).
unsigned long dEmits = 0, dImuMiss = 0, dStale = 0;
unsigned long dEmitMin = 0xFFFFFFFF, dEmitMax = 0, dEmitSum = 0, dEmitN = 0;
unsigned long dImuMax = 0, dImuSum = 0, dPrintMax = 0, dPrintSum = 0;
unsigned long dLoopGapMax = 0, dPumpGapMax = 0, dSerChkMax = 0;
unsigned long dFramesOk = 0, dCsFail = 0, dSkipped = 0, dPdiagOk = 0;
int dRxMax = 0;
float dGyroMax = 0, dAccMin = 99, dAccMax = 0;
unsigned long lastEmitTnow = 0, lastLoopUs = 0, lastPumpUs = 0, lastDiagMs = 0;
unsigned long lastDiagWriteUs = 0;   // how long the previous diag line's single write took
// A diag write stalls the loop once a second; don't let that pollute the gap and
// interval maxima it is trying to measure (each flag is cleared where it's used).
bool skipLoopGap = false, skipPumpGap = false, skipEmitIv = false;

// Collect-on-demand. The boards run the IMUs only while a collection is active,
// not free-running from power. "Active" = the USB port is open (a host -- the
// collector, the GUI, even the Serial Monitor -- has it open), detected via
// `Serial`. On start we calibrate + seed fresh; while active we forward a keepalive
// to the peripheral so it runs in lockstep; on port close everything idles.
bool collecting = false;
unsigned long lastKeepAliveMs = 0;
const unsigned long KEEPALIVE_MS = 200;       // how often to poke the peripheral while active

// Read sensors with the reflection fixed (negate x -> right-handed frame).
inline void readAccel(float &ax, float &ay, float &az) {
  IMU.readAcceleration(ax, ay, az); ax = -ax;
}
inline void readGyro(float &gx, float &gy, float &gz) {
  IMU.readGyroscope(gx, gy, gz); gx = -gx;
}

void calibrateGyroBias() {
  const int N = 300;
  float sx = 0, sy = 0, sz = 0;
  int got = 0;
  unsigned long t0 = millis();
  while (got < N && millis() - t0 < 4000) {
    if (IMU.gyroscopeAvailable()) {
      float gx, gy, gz;
      readGyro(gx, gy, gz);
      sx += gx; sy += gy; sz += gz; got++;
    }
  }
  if (got > 0) {
    float bx = sx / got, by = sy / got, bz = sz / got;
    float m = max(fabs(bx), max(fabs(by), fabs(bz)));
    if (m <= BIAS_SANITY_DPS) {          // trust only if the board was still
      gyroBias[0] = bx; gyroBias[1] = by; gyroBias[2] = bz;
    }  // else leave 0 (a moving startup would otherwise destabilize the filter)
  }
}

void seedFromAccel(float ax, float ay, float az) {
  float roll  = atan2(ay, az);
  float pitch = atan2(-ax, sqrt(ay * ay + az * az));
  float cr = cos(roll * 0.5f),  sr = sin(roll * 0.5f);
  float cp = cos(pitch * 0.5f), sp = sin(pitch * 0.5f);
  q0 = cr * cp; q1 = sr * cp; q2 = cr * sp; q3 = -sr * sp;
}

void mahonyUpdate(float gx, float gy, float gz,
                  float ax, float ay, float az, float dt) {
  float amag = sqrt(ax * ax + ay * ay + az * az);
  if (amag > 1e-6f) {
    // Soft gate: 1.0 near static, ramping to 0.0 as |accel| leaves 1 g.
    float err = fabs(amag - 1.0f);
    float trust;
    if (err <= ACC_TRUST_FULL_G)      trust = 1.0f;
    else if (err >= ACC_TRUST_ZERO_G) trust = 0.0f;
    else trust = (ACC_TRUST_ZERO_G - err) / (ACC_TRUST_ZERO_G - ACC_TRUST_FULL_G);

    if (trust > 0.0f) {
      float recipNorm = 1.0f / amag;
      ax *= recipNorm; ay *= recipNorm; az *= recipNorm;

      float halfvx = q1 * q3 - q0 * q2;
      float halfvy = q0 * q1 + q2 * q3;
      float halfvz = q0 * q0 - 0.5f + q3 * q3;

      float halfex = (ay * halfvz - az * halfvy) * trust;
      float halfey = (az * halfvx - ax * halfvz) * trust;
      float halfez = (ax * halfvy - ay * halfvx) * trust;

      if (TWO_KI > 0.0f) {
        integralFBx += TWO_KI * halfex * dt;
        integralFBy += TWO_KI * halfey * dt;
        integralFBz += TWO_KI * halfez * dt;
        gx += integralFBx; gy += integralFBy; gz += integralFBz;
      }
      gx += TWO_KP * halfex; gy += TWO_KP * halfey; gz += TWO_KP * halfez;
    }
  }

  gx *= 0.5f * dt; gy *= 0.5f * dt; gz *= 0.5f * dt;
  float qa = q0, qb = q1, qc = q2;
  q0 += (-qb * gx - qc * gy - q3 * gz);
  q1 += ( qa * gx + qc * gz - q3 * gy);
  q2 += ( qa * gy - qb * gz + q3 * gx);
  q3 += ( qa * gz + qb * gy - qc * gx);

  float recipNorm = 1.0f / sqrt(q0 * q0 + q1 * q1 + q2 * q2 + q3 * q3);
  q0 *= recipNorm; q1 *= recipNorm; q2 *= recipNorm; q3 *= recipNorm;
}

void setup() {
  Serial.begin(115200);
  Serial1.begin(115200);        // board-to-board link (must match peripheral). 115200,
                                // not 460800: a 30-byte packet at 50 Hz needs only
                                // ~12 kbaud, and the two boards clock this async link
                                // off independent oscillators that drift apart as they
                                // warm -- the lower rate keeps ample timing margin so
                                // framing errors don't grow over a session.
  while (!Serial) { ; }

  pinMode(LED_BUILTIN, OUTPUT);
  digitalWrite(LED_BUILTIN, LOW);

  if (!IMU.begin()) {
    Serial.println("ERR,IMU init failed");
    while (1) { ; }
  }
  Serial.println("# CENTRAL fw: gated-50hz-onewrite-diag (collect while USB open; shank keepalive-gated)");
  Serial.println("# CENTRAL cols: D,t_thigh_us,tw,tx,ty,tz,tax,tay,taz,"
                 "t_shank_recv_us,sw,sx,sy,sz,sax,say,saz,age_us");
  lastMicros = micros();
  // No IMU calibration here -- it happens fresh in startCollecting(), so each
  // session gets a clean bias and the sensor isn't run while nothing is observing.
}

// Begin a collection: tell the peripheral to start (so it calibrates in parallel),
// then calibrate + seed this board. Held-still assumption applies here, not at boot.
void startCollecting() {
  Serial1.write('S');                  // wake the peripheral (it calibrates in parallel)
  Serial.println("# collecting: calibrating, hold still ~3 s");
  calibrateGyroBias();
  Serial.print("# central gyro bias dps: ");
  Serial.print(gyroBias[0], 3); Serial.print(',');
  Serial.print(gyroBias[1], 3); Serial.print(',');
  Serial.println(gyroBias[2], 3);

  unsigned long t0 = millis();
  while (!IMU.accelerationAvailable() && millis() - t0 < 2000) { ; }
  if (IMU.accelerationAvailable()) {
    float ax, ay, az;
    readAccel(ax, ay, az);
    seedFromAccel(ax, ay, az);
  }
  lastMicros = micros();
  lastEmitUs = micros();
  collecting = true;
  digitalWrite(LED_BUILTIN, HIGH);     // lit = collecting
}

void stopCollecting() {
  Serial1.write('X');                  // tell the peripheral to idle
  collecting = false;
  digitalWrite(LED_BUILTIN, LOW);      // dark = idle
}

// A Print target that accumulates one output line in RAM, so the line can be
// formatted exactly as Serial.print() would format it and then sent in one write.
struct LineBuf : public Print {
  char buf[256];
  size_t len = 0;
  void reset() { len = 0; }
  size_t write(uint8_t c) override {
    if (len >= sizeof(buf)) return 0;   // never overflow; a D line is ~150 bytes
    buf[len++] = (char)c;
    return 1;
  }
  using Print::write;
};
LineBuf line;

// Freshest shank state received from the stream, plus when (central clock) it was
// parsed. shankRecvUs == 0 until the first good packet arrives.
float shankQ[4] = {0, 0, 0, 0};
float shankA[3] = {0, 0, 0};
unsigned long shankRecvUs = 0;

// Persistent frame-assembly state for the free-running stream. We resync on the
// 0xAA header and validate the XOR checksum, so a lost/extra byte costs one frame
// (checksum fail -> drop -> resync to the next header), never a lasting desync.
uint8_t rxBuf[64];
int rxHave = 0;
int rxWant = 0;

// Non-blocking: consume every byte currently buffered, updating the cache with the
// LAST complete, checksum-good packet. Called often so the UART buffer never backs
// up; whatever the peripheral streamed while we were busy is waiting here, not lost.
void pumpShankStream() {
  unsigned long now = micros();
  if (lastPumpUs != 0 && !skipPumpGap && now - lastPumpUs > dPumpGapMax) dPumpGapMax = now - lastPumpUs;
  lastPumpUs = now;
  skipPumpGap = false;
  int avail = Serial1.available();
  if (avail > dRxMax) dRxMax = avail;         // backlog: near the buffer size = overflow risk

  while (Serial1.available()) {
    uint8_t b = Serial1.read();
    if (rxHave == 0) {                        // hunting for a header
      if (b == HDR_SHANK)      rxWant = SHANK_FRAME_LEN;
      else if (b == HDR_PDIAG) rxWant = PDIAG_FRAME_LEN;
      else { dSkipped++; continue; }
      rxBuf[0] = b; rxHave = 1;
    } else {
      rxBuf[rxHave++] = b;
      if (rxHave == rxWant) {
        uint8_t cs = 0;
        for (int i = 1; i <= rxWant - 2; i++) cs ^= rxBuf[i];
        if (cs != rxBuf[rxWant - 1]) {
          dCsFail++;                          // bad frame: drop, resync on next header
        } else if (rxBuf[0] == HDR_SHANK) {   // good shank frame -> update cache
          memcpy(shankQ, &rxBuf[1], 16);
          memcpy(shankA, &rxBuf[17], 12);
          shankRecvUs = micros();
          dFramesOk++;
        } else {                              // good peripheral health frame
          memcpy(&pdiag, &rxBuf[1], sizeof(PDiag));
          pdiagFresh = true;
          dPdiagOk++;
        }
        rxHave = 0;
      }
    }
  }
}

#if DIAG
// One buffered write per line (integers only, so no float printf needed). Its
// own duration is reported on the NEXT line as diag_write_us -- a direct
// comparison against print_us, the many-small-prints cost of each data line.
char diagBuf[400];
void diagWrite(int n) {
  if (n <= 0) return;
  if (n > (int)sizeof(diagBuf)) n = sizeof(diagBuf);
  unsigned long t0 = micros();
  Serial.write((const uint8_t *)diagBuf, n);
  lastDiagWriteUs = micros() - t0;
  skipLoopGap = skipPumpGap = skipEmitIv = true;
}

void diagReport() {
  unsigned long up = millis();
  int n = snprintf(diagBuf, sizeof(diagBuf),
    "# CDIAG up_ms=%lu emits=%lu emit_min_us=%lu emit_avg_us=%lu emit_max_us=%lu"
    " imu_avg_us=%lu imu_max_us=%lu imu_miss=%lu print_avg_us=%lu print_max_us=%lu"
    " diag_write_us=%lu loop_gap_max_us=%lu pump_gap_max_us=%lu serial_chk_max_us=%lu"
    " frames_ok=%lu cs_fail=%lu skipped_bytes=%lu rx_max=%d stale=%lu pdiag_ok=%lu"
    " gyro_max_dps=%d acc_min_mg=%d acc_max_mg=%d integ_dps10=%d\n",
    up, dEmits, dEmitN ? dEmitMin : 0, dEmitN ? dEmitSum / dEmitN : 0, dEmitMax,
    dEmits ? dImuSum / dEmits : 0, dImuMax, dImuMiss,
    dEmits ? dPrintSum / dEmits : 0, dPrintMax,
    lastDiagWriteUs, dLoopGapMax, dPumpGapMax, dSerChkMax,
    dFramesOk, dCsFail, dSkipped, dRxMax, dStale, dPdiagOk,
    (int)dGyroMax, (int)(dAccMin * 1000), (int)(dAccMax * 1000),
    (int)(sqrt(integralFBx * integralFBx + integralFBy * integralFBy +
               integralFBz * integralFBz) * RAD_TO_DEG * 10));
  diagWrite(n);

  dEmits = dImuMiss = dStale = 0;
  dEmitMin = 0xFFFFFFFF; dEmitMax = dEmitSum = dEmitN = 0;
  dImuMax = dImuSum = dPrintMax = dPrintSum = 0;
  dLoopGapMax = dPumpGapMax = dSerChkMax = 0;
  dFramesOk = dCsFail = dSkipped = dPdiagOk = 0;
  dRxMax = 0;
  dGyroMax = 0; dAccMin = 99; dAccMax = 0;
}

void pdiagReport() {
  const PDiag &p = pdiag;
  int n = snprintf(diagBuf, sizeof(diagBuf),
    "# PDIAG up_ms=%lu active=%u pkts=%u keepalives=%u rate_reinits=%u stall_reinits=%u"
    " begin_fails=%u last_reinit_ms=%u loop_max_us=%lu send_late_avg_us=%lu"
    " send_late_max_us=%lu gyro_max_dps=%d gyro_avg_dps10=%d acc_min_mg=%d acc_max_mg=%d"
    " integ_dps10=%d bias_dps100=%d bias_ok=%u bad_samples=%u read_max_ms=%u\n",
    (unsigned long)p.upMs, p.active, p.pktsSent, p.keepalives, p.rateReinits,
    p.stallReinits, p.beginFails, p.lastReinitMs, (unsigned long)p.loopMaxUs,
    (unsigned long)p.sendLateAvgUs, (unsigned long)p.sendLateMaxUs,
    p.gyroMaxDps, p.gyroAvgDps10, p.accMinMg, p.accMaxMg, p.integDps10,
    p.biasDps100, p.biasOk, p.badSamples, p.readMaxMs);
  diagWrite(n);
}
#endif

void loop() {
  unsigned long loopNow = micros();
  if (lastLoopUs != 0 && !skipLoopGap && loopNow - lastLoopUs > dLoopGapMax) dLoopGapMax = loopNow - lastLoopUs;
  lastLoopUs = loopNow;
  skipLoopGap = false;

  // Collect only while a host has the USB port open. Closing it idles both boards
  // (the peripheral via the keepalive timing out) so the IMUs aren't run unobserved.
  unsigned long chk0 = micros();
  bool hostOpen = static_cast<bool>(Serial);
  unsigned long chk = micros() - chk0;
  if (chk > dSerChkMax) dSerChkMax = chk;
  if (!hostOpen) {
    if (collecting) stopCollecting();
    return;
  }
  if (!collecting) startCollecting();

  // Keep the peripheral awake while we're collecting (it idles if these stop arriving).
  if (millis() - lastKeepAliveMs >= KEEPALIVE_MS) {
    lastKeepAliveMs = millis();
    Serial1.write('S');
  }

  pumpShankStream();   // keep draining the shank stream

  // Sample the thigh IMU, filter, and emit -- all at a fixed 50 Hz (symmetric with
  // the peripheral; neither board runs faster than the other).
  unsigned long tnow = micros();
  if (tnow - lastEmitUs >= EMIT_PERIOD_US) {
    // Advance on a fixed schedule rather than to "now": resetting to tnow added
    // each cycle's lateness to the next period and stretched 20 ms to ~23 ms
    // (~43.6 Hz). If we've fallen a whole period behind (e.g. a USB stall), resync
    // instead of bursting lines to catch up.
    lastEmitUs += EMIT_PERIOD_US;
    if (tnow - lastEmitUs >= EMIT_PERIOD_US) lastEmitUs = tnow;

    dEmits++;
    if (lastEmitTnow != 0 && !skipEmitIv) {
      unsigned long iv = tnow - lastEmitTnow;
      if (iv < dEmitMin) dEmitMin = iv;
      if (iv > dEmitMax) dEmitMax = iv;
      dEmitSum += iv; dEmitN++;
    }
    lastEmitTnow = tnow;
    skipEmitIv = false;
    unsigned long imu0 = micros();

    if (IMU.accelerationAvailable() && IMU.gyroscopeAvailable()) {
      float ax, ay, az, gx, gy, gz;
      readAccel(ax, ay, az);
      readGyro(gx, gy, gz);           // deg/s, handedness-corrected
      gx -= gyroBias[0]; gy -= gyroBias[1]; gz -= gyroBias[2];
      thighAx = ax; thighAy = ay; thighAz = az;   // cache raw accel for the emit

      float dt = (tnow - lastMicros) * 1e-6f;
      lastMicros = tnow;
      if (dt <= 0 || dt > 0.5f) dt = 1.0f / 50.0f;

      mahonyUpdate(gx * DEG_TO_RAD, gy * DEG_TO_RAD, gz * DEG_TO_RAD, ax, ay, az, dt);

      float gm = sqrt(gx * gx + gy * gy + gz * gz);
      float am = sqrt(ax * ax + ay * ay + az * az);
      if (gm > dGyroMax) dGyroMax = gm;
      if (am < dAccMin) dAccMin = am;
      if (am > dAccMax) dAccMax = am;
    } else {
      dImuMiss++;                     // no fresh IMU sample: thigh orientation not updated
    }
    unsigned long imuUs = micros() - imu0;
    if (imuUs > dImuMax) dImuMax = imuUs;
    dImuSum += imuUs;

    pumpShankStream();                // grab the freshest packet before emitting
    // Age the packet against a timestamp taken AFTER the final pump: that pump can
    // parse a packet whose micros() stamp is later than tnow, and an unsigned
    // subtraction would underflow and look stale. Fail SAFE: clamp to 0 in that
    // case (and across the ~71 min micros() rollover) instead of flagging good data.
    unsigned long tRef = micros();
    unsigned long age = (shankRecvUs == 0 || tRef < shankRecvUs) ? 0
                                                                 : (tRef - shankRecvUs);
    bool shankFresh = (shankRecvUs != 0) && (age <= SHANK_STALE_US);
    if (!shankFresh) dStale++;

    unsigned long pr0 = micros();
    // Assemble the whole line in RAM, then send it with ONE write. Each separate
    // Serial.print() was its own blocking USB transfer: ~36 of them took ~11.7 ms
    // per line (measured), which with the ~10.7 ms IMU read pushed each cycle to
    // ~23 ms (~43 Hz). One write of the same bytes takes well under 1 ms.
    line.reset();
    line.print("D,");
    line.print(tnow);       line.print(',');
    line.print(q0, 4);      line.print(',');
    line.print(q1, 4);      line.print(',');
    line.print(q2, 4);      line.print(',');
    line.print(q3, 4);      line.print(',');
    line.print(thighAx, 4); line.print(',');
    line.print(thighAy, 4); line.print(',');
    line.print(thighAz, 4); line.print(',');
    // Shank block: freshest packet if within SHANK_STALE_US, else the zero sentinel
    // (timestamp + quaternion + accel all 0) so the collector marks it invalid.
    if (shankFresh) {
      line.print(shankRecvUs); line.print(',');
      line.print(shankQ[0], 4); line.print(',');
      line.print(shankQ[1], 4); line.print(',');
      line.print(shankQ[2], 4); line.print(',');
      line.print(shankQ[3], 4); line.print(',');
      line.print(shankA[0], 4); line.print(',');
      line.print(shankA[1], 4); line.print(',');
      line.print(shankA[2], 4); line.print(',');
    } else {
      line.print(0); line.print(',');   // t_shank_recv_us
      for (int i = 0; i < 7; i++) { line.print(0); line.print(','); }  // q+accel
    }
    line.println(age);      // freshest shank packet age (us); 0 if none yet
    Serial.write((const uint8_t *)line.buf, line.len);
    unsigned long prUs = micros() - pr0;
    if (prUs > dPrintMax) dPrintMax = prUs;
    dPrintSum += prUs;
  }

#if DIAG
  if (pdiagFresh) { pdiagFresh = false; pdiagReport(); }
  if (millis() - lastDiagMs >= DIAG_PERIOD_MS) { lastDiagMs = millis(); diagReport(); }
#endif
}
