Jamie215/DualIMU_Goniometer/(commit log)

2026-08-14 Raise master slave-poll timeout from 3ms to 8ms
    The observed dropouts (0,0,0 shank samples) were slow replies missing the
    timeout, not lost packets. At 115200 baud the serial round-trip alone is
    ~1ms (11 bytes * ~87us), leaving only ~2ms of the 3ms budget for slave-side
    scheduling delay. A single in-progress IMU read on the slave (~1.5-2ms) was
    enough to exceed it. Best stationary RTTs of ~1.3ms confirm replies are near
    the serial floor, not truly missing. 8ms still fits inside one ~9.6ms IMU
    sample period so a late reply cannot push the master off its 104Hz cadence.
    Claude-Session: https://claude.ai/code/session_015mymeSm1Me516odUkziQ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
    [master_imu.ino]
2026-08-17 Average zero-offset over hold window; log roll channels
    Update the collector to match the current firmware and harden the angle
    baseline:
    - Capture the full-extension zero-offset by averaging the shank-thigh pitch
    difference over the ~2 s hold window (compute_zero_offset) instead of
    trusting a single sample, so one noisy reading can't skew calibration.
    - Log thigh_roll/shank_roll alongside pitch in the CSV for out-of-plane
    diagnostics; the knee angle stays pitch-based.
    - Warn when no valid samples land in the hold window (zero_offset falls back
    to 0.00).
    - Add a self-test for the averaging helper.
    Also refresh the stale slave firmware comment: the master's slave-poll
    budget is 8 ms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
2026-08-17 Switch to quaternion, placement-independent knee angle
    Replace the pitch-based complementary filter with a full-orientation
    quaternion pipeline so sensor placement no longer has to be repeatable.
    Firmware (master + slave):
    - Each board runs a 6-DOF Mahony filter (accel + gyro, magnetometer unused)
    and maintains an orientation quaternion, seeded from gravity at startup.
    - The slave reply packet is now 18 bytes: 0xAA header, 4 little-endian
    floats (q0..q3), XOR checksum. Master reads the fixed-size packet and
    forwards both quaternions to the PC.
    - Master PC line grows to 12 fields:
    D,t_thigh,tw,tx,ty,tz,t_shank_mid,sw,sx,sy,sz,rtt
    Shank quaternion + midpoint are zeroed on a bad/miss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
    [knee_collector_uart.py, master_imu.ino, slave_imu.ino]
2026-08-17 Diagnose bad stream instead of hanging at zeroing
    The calibration timer only advances when a parseable D line arrives, so a
    wrong-firmware, wrong-format, or dead-slave stream left the collector sitting
    silently at 'zeroing' forever with no feedback.
    - Add wait_for_stream(): before starting the zero clock, block until healthy,
    valid 12-field D lines are flowing, and every few seconds print exactly
    what's wrong -- no data on the port, data that doesn't parse as a 12-field
    D line (old/partial firmware), or D lines whose shank quaternion is always
    the zero sentinel (slave link down).
    - Start the calibration clock only once data is confirmed, so the zero window
    can't elapse before the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
    [knee_collector_uart.py]
2026-08-17 Add 9-DOF (magnetometer) fusion behind USE_MAG toggle
    Add optional magnetometer fusion so heading no longer drifts, while keeping
    the calibration-free 6-DOF path one flag away for A/B testing.
    - New mag_calibrate.ino: min/max hard-iron + soft-iron calibration that prints
    paste-ready MAG_BIAS / MAG_SCALE constants, plus an accel-vs-mag axis dump to
    help verify BMM150->BMI270 axis alignment. Run per board.
    - master_imu.ino / slave_imu.ino: Mahony filter extended to a full 9-DOF update
    that degrades to IMU-only when the mag sample is (0,0,0). USE_MAG (default 1)
    selects 9-DOF vs 6-DOF; set 0 to revert to the known-good accel+gyro filter.
    Per-board MAG_BIAS/MAG_SCALE constants and a m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
    [master_imu.ino, slave_imu.ino]
2026-08-17 Auto-solve BMM150->BMI270 axis alignment in mag_calibrate
    The mag and IMU frames differ by an unknown 90-degree axis swap/flip on this
    board, and a wrong guess makes 9-DOF worse than 6-DOF. Determine it by
    measurement instead of guessing:
    - mag_calibrate.ino now, from one ~40 s tumble, also stores synchronized
    (accel, mag) samples and searches the 24 proper signed-axis permutations for
    the one that holds accel_hat . mag_hat most constant (that dot product is a
    physical invariant only when both vectors are in the same frame). It prints a
    ready-to-paste magToImuFrame() body plus a separation ratio, and warns when
    the tumble was too weak to decide. Logic validated in Python against k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
    [master_imu.ino, slave_imu.ino]
2026-08-17 Merge mag calibration into collector; runtime config, no reflashing
    Make magnetometer setup a runtime, PC-driven operation persisted to a file, so
    moving a board never requires editing source or reflashing. (Mag calibration is
    per-board, not per-placement -- placement is already handled by the zero+sweep.)
    Collector (knee_collector_uart.py):
    - --calibrate-mag master|slave|both: streams raw accel+mag from each board (the
    slave via the master's relay), solves hard-/soft-iron (min/max) and the
    BMM150->BMI270 axis alignment (24 proper signed-axis permutations, chosen by
    minimizing the variance of accel.mag), saves to mag_cal.json, and pushes the
    result to the board. Reports the axis sep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
2026-08-18 Fix mag-cal axis separation and slave config-push race
    Two field failures from the first live calibration:
    - Weak axis separation on the master: raw streaming gated on the fast
    accelerometer and read the magnetometer as a bystander, pairing fresh accel
    with STALE mag. That breaks the accel.mag invariant the 24-permutation solver
    depends on, inflating every candidate's variance and collapsing separation
    (worse the faster you tumble). Now gate raw sampling on the SLOW magnetometer
    and read accel at the same instant, so each pair is simultaneous. The slave
    caches a mag-rate-paired accel+mag sample and only answers 'r' once a real
    pair exists (rawReady), so no zero samples poison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
    [master_imu.ino, slave_imu.ino]
2026-08-18 Strip back to clean 6-DOF; add --monitor bring-up diagnostic
    Reset to a minimal, verifiable baseline after the magnetometer path stalled.
    Nothing about the mag machinery (USB command parser, config relay, streaming)
    was ever confirmed on hardware, and it added a lot that could break basic
    bring-up, so remove it entirely and get the plain 6-DOF pipeline working first.
    - Back to a clean 6-DOF Mahony (accel+gyro) that emits/answers orientation
    quaternions. Removed the runtime-config protocol, raw-stream mode, mag read,
    and the master<->slave config relay. The D-line format and 18-byte quaternion
    packet are unchanged.
    - Enable a modest gyro-bias integral (Ki) --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
    [knee_collector_uart.py, master_imu.ino, slave_imu.ino]
2026-08-18 Add startup gyro-bias calibration to kill 6-DOF yaw drift
    The monitor showed the relative angle climbing at rest -- classic 6-DOF yaw
    drift: gravity pins roll/pitch but can't observe heading, so an uncorrected
    yaw-axis gyro bias integrates freely and the orientation rotates on its own.
    A BMI270 bias of even 1-3 deg/s is tens of degrees per minute of drift.
    Both sketches now average the gyro for ~3 s at startup (board held still) to
    estimate the resting bias and subtract it from every sample. The master prints
    its measured bias ("# master gyro bias dps: ...") so the magnitude is visible
    for diagnosis. Requires keeping the boards still for the first few seconds
    after reset/power-up.
    Co-Autho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
    [master_imu.ino, slave_imu.ino]
2026-08-18 Add gravity-referenced (heading-immune) knee angle as default
    Turn each segment into a drift-free sagittal inclinometer from the gravity
    direction in its own frame, and take the difference. Gravity-in-board is
    invariant to yaw, so this is immune to the 6-DOF heading drift that made the
    relative-quaternion angle wander at rest -- and it's also immune to constant
    mounting and to board rotation about the leg's long axis (angles between
    board-frame vectors), and to position. It measures the sagittal-plane
    component, which is exactly upright knee flexion.
    Math (validated in the self-test against random mounts, a turning shared
    heading, and independent per-board yaw drift -- exact recovery):
    d_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
    [knee_collector_uart.py]
2026-08-18 Read gravity from raw accel; fix library reflection; guard bias
    Diagnosis (from the rigid-stationary-ruler test + the shared PDF analysis, and
    confirmed against the Arduino_BMI270_BMM150 source): the fault is in the
    quaternion/filter layer, not the Python angle math.
    1. The library returns accel/gyro as (x,y,z)=(-sensor.y,-sensor.x,sensor.z) --
    determinant -1, a REFLECTION into a LEFT-handed frame. A quaternion filter
    needs right-handed axes (angular velocity is axial), so the gyro's rotation
    sense was mirrored vs the accel and the filter wandered. Fix: negate x of
    both accel and gyro (readAccel/readGyro) to restore det +1.
    2. The startup gyro-bias calibration could capture moti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
    [knee_collector_uart.py, master_imu.ino, slave_imu.ino]
2026-08-18 Motion-robust filter (accel gating) + faster UART link
    #2 fast motion: add accelerometer-magnitude gating to the Mahony filter -- the
    accel correction is applied only when |accel| is within 0.15 g of gravity, so
    linear acceleration during quick movement no longer pulls the tilt estimate;
    the gyro carries through. With the handedness now fixed, gravity-from-quaternion
    (--gravity-source quat) is thus a smooth, drift-free signal for dynamic motion,
    while raw accel (default) stays best for slow/quasi-static.
    #3 UART dropouts: raise the board-to-board Serial1 baud 115200 -> 460800 on both
    boards. The reply grew to 30 bytes, so at 115200 transmission alone was ~2.7 ms
    of the 8 ms budget (round-tr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
    [master_imu.ino, slave_imu.ino]
2026-08-18 Add README: system overview, math, protocol, and findings log
    Document the current design (6-DOF gravity-referenced knee angle), the hardware/
    wiring, quick-start and command reference, the wire/CSV formats, and a findings
    log capturing the key debugging discoveries (library left-handed axis reflection,
    gyro-bias runaway guard, 6-DOF yaw drift, raw-accel bypass, accel-magnitude
    gating, and the UART baud fix), plus known limitations and next steps.
    Claude-Session: https://claude.ai/code/session_015jfTtzZRJWx4wKLYQbCsJd
2026-08-19 Consolidate to one reliable angle: gyro-fused gravity-referenced
    The "reads 0/erratic after returning from a high angle" symptom came from the
    default angle path reading gravity from the RAW accelerometer, which measures
    gravity + linear acceleration during any brisk motion (e.g. swinging the leg
    back), so its direction is momentarily wrong and the collector had no motion
    protection on that path. The four selectable behaviors
    (--method gravity|quat x --gravity-source accel|quat) also masked each other's
    failure modes.
    Collapse to a single method: gravity-in-board taken from the fused Mahony
    quaternion. Now that the library-handedness reflection is fixed, that direction
    is both smooth throug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
    [knee_collector_uart.py, master_imu.ino, slave_imu.ino]
2026-08-19 Document the angle math in README; tidy stale header comment
    - README "How it works" now carries the full derivation of the
    gravity-referenced knee angle: gravity-in-board from the quaternion,
    the d_i (zero) and f_i (forward) calibration vectors, the signed
    atan2 inclination, and the knee difference -- each step cross-linked
    to the function that implements it. Adds a short placement-independence
    proof sketch and reframes the trade-off as a 2-of-3-DOF observability
    limit (why a tilt + out-of-plane motion is unrecoverable).
    - No code changes were needed for cleanup: the consolidation left no
    dead helpers or stale references (verified); refreshed only the master
    sketch's header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
2026-08-19 Add live collection + visualization GUI for POC testing
    New knee_gui.py: a Tkinter + Matplotlib front end over the existing
    gravity-referenced angle math, aimed at proof-of-concept testing sessions.
    - Port scan: probes each serial port for valid 'D' lines and auto-picks
    the master (the slave is diagnosed through it via shank-valid %).
    - Consistent 100 Hz: a background sampler resamples the jittery ~104 Hz
    device stream onto a fixed 10 ms grid for both the CSV and the plots.
    - Obvious calibration: a colour-coded banner drives ZEROING -> SWEEP ->
    RUNNING with a live countdown and a shank-tilt readout during the sweep.
    - Visualization: knee angle plus the two segment inclin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
    [knee_collector_uart.py, knee_gui.py]
2026-08-19 Replace pause/resume with session-based collect/stop/reset
    Two fixes from testing feedback:
    - The display no longer rolls while not collecting. The sampler now only
    appends to the plot (and writes the CSV) while a session is active
    (zeroing/sweep/running); when stopped it does nothing, so the plot
    freezes on the last data instead of scrolling with empty samples.
    - "Pause/Resume" is replaced by "Stop collecting". Stop resets the
    calibration and returns to idle; the next "Calibrate & collect" is a
    clean reset -- a new timestamped CSV, a cleared plot, and calibration
    from scratch. Collection is now session-based, one CSV file per run,
    opened on session start an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
    [knee_gui.py]
2026-08-19 Make plots inspectable once collection stops
    Add Matplotlib's pan/zoom/save navigation toolbar. While collecting, the
    plots keep their live rolling window. On Stop, the view does a one-time
    "fit the whole session" autoscale and then stops driving the axes, so the
    toolbar's pan/zoom (and Home) stick and the frozen trace can be examined.
    Home is reset to the fitted full-session view. A new collection resumes the
    live rolling behavior.
    Claude-Session: https://claude.ai/code/session_018ev7EKj2h7krWgDPDsDJrA
    [knee_gui.py]
2026-08-19 Show the entire session (not just the rolling window) when stopped
    The live plot buffer is a bounded ring (~12.5 s), so the "fit all" on Stop
    only covered the last window -- earlier data, including calibration, was
    already evicted. Keep a separate unbounded full-session history alongside
    the ring: live plotting still uses the fast bounded ring, but the frozen
    view after Stop now plots the whole run from first sample to last. The
    history is cleared at the start of each session.
    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
2026-08-20 Document what 0 deg reflects in the knee angle
    The gravity-referenced angle is RELATIVE to the pose held during the static
    zero: whatever posture is held becomes 0 deg, regardless of the true anatomical
    geometry. A leg that is anatomically straight but sits at a residual angle still
    reads 0 deg, so every reading is a change from the zeroing pose, not an absolute
    femur-vs-tibia angle.
    Add a clear note to the module docstring and the README explaining this: the
    readings are correct for ROM (max - min), rep counting, and movement quality
    (all difference-based, so the reference cancels), but are not absolute clinical
    angles and are not comparable across sessions zeroed on different poses.
    Recov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
    [knee_collector_uart.py]
2026-08-20 Fix progressive shank dropouts on the board-to-board UART link
    The shank (slave) samples degraded over a session -- rtt climbing and
    valid% falling together -- because pollSlave() read a fixed 30 bytes with
    no header resync. A single lost or extra byte on the async link shifted
    every following packet by one, and the misalignment was self-sustaining:
    each poll's 30 bytes straddled a packet boundary, so successful
    round-trips got longer (rtt up) while a growing fraction timed out
    (valid% down). It worsened as the two boards' independent UART oscillators
    drifted apart with self-heating, which the 460800 baud rate (thin per-byte
    timing margin) made worse.
    - Resync on the 0xAA header before read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
    [master_imu.ino, slave_imu.ino]
2026-08-20 Widen slave response window and make dropped polls self-diagnosing
    At 115200 a successful round-trip is ~3.6 ms, but observed valid% was ~53%:
    the failures are late replies, not slow transmission. The slave only answers
    'R' at points in its own ~104 Hz loop and the mbed RTOS can add sporadic
    multi-ms stalls, so a reply sometimes arrives several ms after the request.
    The 6 ms window discarded those.
    The master loop is gated by its own IMU (~9.6 ms/sample), so a wider timeout
    only extends the occasional late poll -- average rate barely changes -- and
    knee flexion needs far less than 100 Hz. Trade peak rate for completeness:
    - SLAVE_TIMEOUT_US 6 ms -> 12 ms, wide enough to catch a reply delay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
    [knee_collector_uart.py, master_imu.ino]
2026-08-20 Switch shank link from polling to streaming to decouple master from slave latency
    Widening the response window raised valid% to ~93%, but the residual drops
    showed rtt pinned at the full timeout: the slave produces nothing in time,
    not corrupt bytes. The slave answered a poll only between chunks of its own
    loop, and the mbed RTOS adds sporadic multi-ms stalls, so a reply can miss
    any fixed deadline -- and the frequency grows as the board warms. Widening
    the timeout is an arms race, and every stall stalls the master too.
    Restructure the board-to-board link from request/response to streaming:
    - Slave: free-runs, streaming one 30-byte packet per IMU update (~104 Hz).
    No 'R' handling; it no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
    [knee_collector_uart.py, master_imu.ino, slave_imu.ino]
2026-08-20 Fix unsigned underflow in shank packet-age computation
    The age was computed as `now - shankRecvUs`, but `now` is captured before
    the final pumpShankStream(), which can parse a just-arrived packet and stamp
    shankRecvUs with a micros() value LATER than now. The unsigned subtraction
    then underflowed to ~4.29e9 us, blew past SHANK_STALE_US, and marked the
    freshest samples invalid -- exactly the cycles where a new packet had just
    arrived. That dropped valid% to ~20% (only cycles with no new packet in the
    final window computed a sane age).
    Take the age reference timestamp AFTER the final pump so it is always
    >= shankRecvUs. The previously-underflowing majority now read a small, real
    age and count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
    [master_imu.ino]
2026-08-20 Fail-safe shank age + firmware banner tag
    The 4294967118 us "age" (an unsigned wrap of ~-178 us) can only come from a
    pre-fix streaming build. Make the current build incapable of reproducing it:
    clamp age to 0 when tRef < shankRecvUs (reordering or the ~71 min micros()
    rollover) so a good sample can never be flagged stale by an unsigned wrap.
    Also print a firmware banner line ("# MASTER fw: stream-2 ...") at startup so
    the flashed build is identifiable from --raw, distinguishing the fixed
    streaming firmware from an older build still on the board.
    Claude-Session: https://claude.ai/code/session_01YNUTSXLNcJdEWxpJ9HoYWV
    [master_imu.ino]
2026-08-20 Add master-loop-period readout to --monitor to localize stalls
    The streaming redesign removed the frequent short (ms) shank dropouts, but a
    rare multi-second age spike (e.g. 8.5 s) still appears, which needs its source
    localized before it can be fixed. Show the master's own loop period, derived
    from its t_thigh_us clock, on every monitor line.
    Reading it during a big-age event is decisive:
    - master dt also jumps to seconds -> the MASTER froze (both boards' data
    freeze together; classic USB-print backpressure when the host stalls).
    - master dt stays ~10 ms while shank is stale -> the master is fine and the
    SLAVE went silent (reset / power / sensor).
    No firmware change; this only adds i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
    [knee_collector_uart.py]
2026-08-20 Slave: recover from BMI270 data-ready stalls + LED stall indicator
    Field diagnosis (master dt stayed ~18 ms while shank age hit 10.8 s) localized
    the multi-second shank outages to the SLAVE: the BMI270 stops asserting new
    data, and since the slave streams only inside the accel/gyro-available guard,
    the loop spins silently until the sensor un-sticks.
    - If no IMU sample arrives for STALL_WARN_MS (250 ms), light LED_BUILTIN so the
    stall is visible on the board (lets the outage be correlated with power/cable
    physically), and re-init the BMI270 at most every REINIT_EVERY_MS (500 ms) to
    recover in ms instead of waiting seconds for it to un-stick.
    - LED is driven LOW on every good sample (he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
    [slave_imu.ino]
2026-08-20 Slave: add boot-blink to distinguish reset from sensor hang
    "No LED during a multi-second outage" is ambiguous: it can mean the slave
    firmware isn't flashed, the board wasn't being watched, or the loop isn't
    running at all (reset/brown-out) so the stall-LED path never executes.
    Add a 3-flash boot blink at every (re)start. It disambiguates:
    - seen at plug-in -> this firmware is confirmed flashed
    - seen mid-session -> the board reset (brown-out / fault) => slave POWER issue
    - solid LED during an outage (existing) -> sensor data-ready hang
    - nothing at all -> not flashed, or not observed
    Diagnostic only; no protocol/behavior change.
    Cl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
    [slave_imu.ino]
2026-08-20 Slave: use onboard RGB LED for an unmissable health indicator
    The tiny built-in LED was easy to miss. Drive the Nano 33 BLE Rev2 onboard RGB
    LED (active-low) with a clear state encoding so the slave's health is obvious
    and the failure modes are self-distinguishing:
    GREEN solid = healthy, streaming
    RED solid = sensor stalled (loop running, re-init firing)
    BLUE 3x = boot; at plug-in confirms firmware flashed, mid-session = reset
    dark = loop not running (hard fault) or unpowered
    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
    [slave_imu.ino]
2026-08-20 Ignore '#' banner lines in wait_for_stream diagnosis
    The master prints '# MASTER cols: ...' and '# MASTER fw: ...' banners at boot.
    The cols banner happens to contain 18 commas, so wait_for_stream counted it as
    a seen line and diagnose_stream reported the misleading "isn't an 18-field 'D'
    line (last line had 18 fields)". Skip lines starting with '#' so the diagnosis
    reflects only real data lines.
    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
    [knee_collector_uart.py]
2026-08-20 Slave: move health indicator to built-in LED (RGB dead on this unit)
    The onboard RGB LED is dead on the shank board, so encode state as a blink
    pattern on LED_BUILTIN instead of colour:
    steady heartbeat blink = healthy, streaming
    solid on = sensor stalled (loop running, re-init firing)
    3 fast flashes at start = boot (plug-in = flashed; mid-session = reset)
    off / frozen = loop not running or unpowered
    Non-blocking heartbeat toggle in the healthy path; no protocol/behavior change.
    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
    [slave_imu.ino]
2026-08-20 Slave: auto re-init the IMU on low sample rate (no manual reset)
    Observed: the shank board had to be manually reset almost every session. Root
    asymmetry: opening the master's USB port resets the master (DTR), so its IMU is
    freshly initialised each session, but the slave free-runs from power with nothing
    to re-init it -- so a bad low-rate power-up state (e.g. ~10 Hz with non-physical
    accel, seen in raw dumps) persisted until a hand reset.
    Give the slave the same automatic fresh start:
    - Rate watchdog: count streamed samples per 1 s window; if under
    MIN_SAMPLES_PER_WINDOW (60; healthy ~104), force a full sensor re-init. Heals a
    bad power-up within ~1 s, at boot and mid-session, without a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
    [slave_imu.ino]
2026-08-20 Add a fixed 50 Hz baseline (throttle stream + emit) for timing margin
    Move both boards from free-running at the sensor rate (~104 Hz) to a fixed
    50 Hz, to maximise timing margin on the async board-to-board link and the USB
    output. 50 Hz is well above knee-ROM bandwidth (and it's resampled PC-side).
    - Slave: process + stream at most once per STREAM_PERIOD_US (20 ms). Halves
    packets on the wire (~13% link utilisation) and lightens the loop.
    - Master: run the thigh filter at full sensor rate for smoothness but emit one
    merged PC line every EMIT_PERIOD_US (20 ms); cache the thigh raw accel for the
    throttled emit. Banner -> stream-50hz.
    - Rate-watchdog threshold retuned to the 50 Hz stream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
    [master_imu.ino, slave_imu.ino]
2026-08-20 Collect-on-demand gating + symmetric 50 Hz sampling
    Both boards now run their IMUs only while a collection is active, and both sample
    at 50 Hz (previously the master read at ~104 Hz while the slave was 50 Hz).
    - Master: gate on the USB connection (`Serial`). Opening the port (collector, GUI,
    or Serial Monitor -- no PC-side command needed) starts a collection: calibrate +
    seed fresh, then stream at 50 Hz and forward a keepalive ('S') to the slave.
    Closing the port idles the board. Master IMU now sampled at 50 Hz too (symmetry).
    - Slave: no longer free-runs. Idles (slow blink) until the master's keepalive
    arrives, then calibrates + streams at 50 Hz; idles again on 'X' or keepalive
    t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
    [knee_collector_uart.py, master_imu.ino, slave_imu.ino]
2026-08-20 Cleanup pass: refresh stale comments and the dead-slave hint
    Bring comments in line with the final gated 50 Hz design:
    - Slave rate-watchdog / stall-recovery: drop the old "free-runs from power" and
    "seen in the field" narration; describe the current active/idle behaviour.
    - Slave LED block: drop the unit-specific "RGB is dead" aside.
    - Master SHANK_STALE_US: 50 Hz packet interval (~20 ms), not the old ~104 Hz.
    - reinitIMU: "default output rate" rather than a specific Hz.
    - Collector dead-slave diagnostic: mention the slave's idle-vs-active LED and that
    BOTH UART wires (incl. the new Master TX->Slave RX keepalive) must be connected.
    Comment/diagnostic text only; no behaviour change. Sel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
    [knee_collector_uart.py, master_imu.ino, slave_imu.ino]
2026-09-21 Reconcile PC-side sample rate to the firmware's 50 Hz baseline
    The GUI resampled onto a 100 Hz grid and labeled its CSV/plots "100 Hz",
    but the firmware emits and streams at a fixed 50 Hz (EMIT_PERIOD_US /
    STREAM_PERIOD_US = 20000 us). With a 50 Hz source, the 100 Hz grid was
    upsampling -- only ~half the grid points carried a fresh sample -- and the
    "~104 Hz device stream" comments predated the 50 Hz baseline.
    - knee_gui.py: SAMPLE_HZ 100 -> 50 (drives GRID_DT and PLOT_N); refresh the
    stale docstring, sampler-thread comment, running-status string, and the
    synthetic source rate (104 -> 50 Hz) to match the real device.
    - knee_collector_uart.py: fix the MAX_FILL comment (10 samples is ~200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
    [knee_collector_uart.py, knee_gui.py]
2026-09-21 Rename slave/master to peripheral/central
    Replace the master/slave terminology throughout the project with the
    central/peripheral terms:
    - Rename directories and sketches: master_imu/master_imu.ino ->
    central_imu/central_imu.ino, slave_imu/slave_imu.ino ->
    peripheral_imu/peripheral_imu.ino (Arduino sketch folder name kept in
    sync with the .ino file name).
    - Update all comments, docstrings, firmware banners, wiring notes, and
    diagnostic messages in the .ino sketches, knee_collector_uart.py,
    knee_gui.py, and README.md, preserving casing.
    - Left the Tkinter FigureCanvasTkAgg(master=...) keyword argument
    untouched, since it is a library API parameter, not the removed
    terminology.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
    [central_imu.ino, knee_collector_uart.py, knee_gui.py, peripheral_imu.ino]
2026-09-22 Add areas-to-explore doc: magnetometer analysis + absolute-vs-relative angle
    Capture this session's investigation into using the onboard BMM150
    magnetometer. Records what the magnetometer can and cannot enable, the
    scale-vs-zero framing, the derivation of why an Earth reference does not
    yield an absolute anatomical angle, the design trade-offs, and a cheap
    field-quality test to decide empirically. Adds a second area for the
    functional/anatomical calibration path that would actually recover an
    absolute angle. Structured as a running log for future exploration areas.
    Claude-Session: https://claude.ai/code/session_01WAUTDWuWBduEi4ME1Z7cvL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
2026-09-22 Add Area 3 to exploration doc: Bluetooth (BLE) links
    Capture the idea of replacing the wired links with BLE at two levels:
    peripheral-central (board-to-board) and central-collector (board-to-PC).
    Records the REB/safety motivation for removing wires, a brief how, and the
    anticipated drawbacks (dropouts, timing jitter, rate) with mitigations
    (source-side timestamps, per-notification framing, batching).
    Claude-Session: https://claude.ai/code/session_01WAUTDWuWBduEi4ME1Z7cvL
2026-09-22 Add Area 4 to exploration doc: scaling to multiple nodes / joints
    Capture the idea of multi-pair / multi-node setups: a star of several
    peripherals to one central, or multiple independent central-peripheral
    pairs, to measure multi-joint chains (hip-knee-ankle) or bilateral capture.
    Notes node addressing, cross-node time alignment as the main correctness
    risk, bandwidth scaling, per-segment calibration, and the topology
    trade-off. Ties to the BLE area (fan-out favors BLE).
    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
2026-09-22 README: link to docs/areas_to_explore.md from next steps
    Point the Known limitations & next steps section at the new exploration log
    covering the magnetometer, absolute-angle calibration, BLE links, and
    multi-node scaling.
    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
2026-09-23 Static test findings: address review questions, add calibration analysis
    Drop handling-dependent settling metric and creep observation, explain drift
    slope and Allan deviation, clarify duplicate rows (emit-period firmware cause),
    and add recomputed calibration vectors / desk-node stability.
    Claude-Session: https://claude.ai/code/session_01AxnhBNGVNZa62atbRd2ZEw
2026-09-23 Central: emit on a fixed 50 Hz schedule instead of resetting to now
    Resetting lastEmitUs to the current time added each cycle's lateness to the
    next period, stretching the emit interval to ~22.9 ms (~43.6 Hz) in the static
    tests. Advance by EMIT_PERIOD_US instead, resyncing if a full period behind so
    a stall doesn't cause a burst. Banner renamed to gated-50hz-sched so logs show
    which firmware ran. Note the fix and the packet-age observation in FINDINGS.
    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
    [central_imu.ino]
2026-09-24 Static test findings: add session 2 (raised rig, runs 4-6)
    Document what the raised-rig runs show (noise floor, link reliability,
    non-level zero pose, rig baseline, drift upper bound) and what they can't,
    and record that the emit-timer change did not change the ~23 ms period.
    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
2026-09-24 Add diagnostic build for both boards and log it from the GUI
    Central: once-a-second '# CDIAG' line with emit interval, IMU-read and
    print durations, loop/pump gaps, Serial check time, UART backlog, frame
    and checksum counters, stale count and thigh IMU health. The diag line is
    one buffered write, timed, for comparison with the per-field prints.
    Parser now also accepts the peripheral's 0xAB health frame and relays it
    as '# PDIAG'.
    Peripheral: once-a-second health frame over the existing link with
    packets sent, keepalives, low-rate/stall re-init counts and duration,
    IMU.begin failures, loop and send lateness, gyro/accel magnitude ranges,
    Mahony integral magnitude and gyro-bias acceptance.
    GU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
    [central_imu.ino, knee_gui.py, peripheral_imu.ino]
2026-09-24 Findings: session 2 nodes were ~5 cm apart; zero-pose tilt fits the step
    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
2026-09-24 Findings: state the effective sample rate and that static results are unaffected
    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
2026-09-24 Add static stability test report with summary figure
    REPORT.md summarises both sessions for sharing: purpose, setup, results
    (one stability table, one figure), the three issues found (effective
    ~40 Hz rate, ruler-node sensor fault, only one node exercised), limits and
    next steps. plot_report.py recreates the figure. FINDINGS.md stays as the
    detailed record and links to the report.
    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
2026-09-24 Firmware: one-write data lines on the central, sensor-fault guard on the peripheral
    Central: build each D line in RAM with the same Print formatting and send
    it with a single Serial.write. The diagnostic run measured ~11.7 ms for the
    ~36 separate prints (plus ~10.7 ms IMU read = ~23 ms/cycle, ~43 Hz); one
    write of a longer line took ~0.7 ms, so the cycle fits in 20 ms again.
    Peripheral: in a long test its BMI270 degraded after ~20 min (reads hanging
    ~190 ms and returning garbage, gyro 1500-2400 deg/s while still), then
    stopped producing data even though IMU.begin() reported success.
    - Reject implausible samples (hung read, |accel| outside 0.25-4 g, >1000
    deg/s with |accel| ~1 g) and send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
2026-09-24 Docs: long-run diagnostic findings; correct the stall explanation
    The ~190 ms stalls are hung sensor reads, not self-heal restarts; the
    ruler board never reset and the link stayed clean. REPORT.md, the .docx
    and FINDINGS.md now describe the ~20 min sensor failure, the measured
    timing split, and the firmware changes awaiting a test run.
    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
2026-09-24 GUI: write one CSV row per received sample
    The sampler used to write a row every 20 ms from the latest snapshot. On
    Windows that timer ticks unevenly, so even with the board at a true 50 Hz
    ~20 % of rows repeated a sample and ~10 samples/s were never written.
    The collector now queues every parsed data line (bounded; oldest dropped
    and counted if the writer falls a minute behind) and the sampler writes
    exactly one row per queued sample. t_session_s now comes from the board's
    micros() clock (32-bit wrap handled), so row timing is measurement timing;
    t_wall_iso is PC arrival time. A Stop still ends the session when no data
    is arriving. Self-test adds an end-to-end check: no duplicate t_thigh_u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
2026-09-24 Report: board-swap result, confirmed rate fix, 1-hour hold, 45/90 rig check
    REPORT.md and the .docx are rewritten around the latest results: the
    sensor fault follows one physical board (replace it), the 50 Hz and
    one-row-per-sample fixes are confirmed (0 duplicate rows), a 57-minute
    clean hold (drift -0.001 deg/min), and a preliminary 45/90 degree rig
    check (45.0 and 89.0 deg, with the reference-node caveat). Also notes
    that valid % only reflects the shank node's data.
    FINDINGS.md gains sections 9-11 with the per-run detail.
    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
2026-09-24 Report: restructure (purpose, testing, setup, results, issues, limitations, conclusions)
    - New order: purpose of the document, what we are testing, setup,
    results, issues found, limitations, conclusions and next steps.
    - Issue 2 rewritten retrospectively: long-session data loss traced to a
    faulty board, not an action item.
    - The one-node-exercised finding and the valid-% caveat move to
    Limitations.
    - The next-steps table becomes a written conclusions section: what was
    tested, what was found and addressed, and recommended next steps.
    - build_report_docx.js now converts REPORT.md directly, so the Word
    version can't drift from the Markdown.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
2026-09-24 Report (Word): fill in the endurance test and restyle the remaining sections
    Starting from the Word version edited by hand up to the 45/90 section,
    the remaining content now follows the same format: Heading 2 sections,
    'Table N:' captions, grey italic notes, and bold-lead bullets with
    detail sub-bullets.
    - Endurance Test filled in: the three long runs (Table 3) and angle
    stability over their clean windows (Table 4; long run 3 limited to the
    33 min before the thigh node's fault affected data flow).
    - Other checks, Issues Found, Limitations, Conclusions and Next Steps,
    and Files rewritten in the same style; tables renumbered 1-8 in order.
    - 'Allen' corrected to 'Allan' in two places.
    R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
2026-09-25 Report (Word): consistency pass and prose conclusions
    Starting from the latest hand-edited version:
    - Headings in title case; Issues Found headings use the same automatic
    numbering as the Findings headings (restarting at 1) instead of typed
    numbers; empty heading-styled spacer paragraphs made plain.
    - 'Table N:' / 'Figure N:' captions throughout; Figure 1 now carries the
    caption that described it, and Table 1 gets its own.
    - Note markers: a star only where a table cell carries one.
    - Endurance runs named consistently ('endurance run N', '3 (roles
    swapped)'); setup table and text agree on 24-60 min and 20-38 min.
    - The 45/90 bullets and one dash sub-bullet reformatted to match the
    b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
2026-09-25 Add plots for the 45/90 degree angle-rig check
    plot_angle_rig.py draws, for each rig, the whole recording and the steady
    window zoomed around nominal: the reported angle plus the shank node's
    filter-free accelerometer tilt (same zero pose and bending direction as
    the report's cross-check: 45.20 and 88.98 degrees).
    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
2026-09-25 Add thigh-vs-shank node tilt plot for the angle-rig check
    plot_angle_rig.py now also writes angle_rig_nodes.png: each node's tilt
    from its own zero pose, taken from its raw accelerometer (the software
    treats the thigh node as fixed here, so incl_thigh is always 0), with the
    thigh node zoomed in the bottom row.
    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
2026-10-09 Add handover docs: design decisions, build/use SOP, handover summary
    - docs/DESIGN_DECISIONS.md: every major design choice with rationale,
    alternatives, evidence (commits / test report) and status, plus a timeline.
    - docs/SOP_Build_and_Use.md: BOM, wiring, flashing, Python setup, placement,
    running a GUI/CLI session, data handling, troubleshooting. Physical-build
    details not recorded in the repo are marked [TO FILL].
    - docs/HANDOVER.md: current state, repo map, open issues (faulty board, raw
    data not preserved), prioritised next steps.
    - Word copies of all three, regenerated by docs/build_docs.sh (pandoc) with
    styling matched to the stationary test report.
    - README: link the handov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
2026-10-09 SOP: adopt the edited Word file as master and complete its TODOs
    - docs/SOP_Build_and_Use.docx is now the edited Word version (prototype
    photo, pinout figure, 3-D printed case, elastic straps) with the three TODOs
    done: a plain-language Python setup walkthrough (4.3), guidance on where to
    place the sensors to keep skin/muscle movement low (6), and GUI screenshots
    for each step of a session, taken in simulate mode (Figures 3-7).
    - Plainer wording throughout for non-technical readers; fixed the
    troubleshooting cross-reference (now 9), case printing (two cases, base +
    lid), and the leftover "archive" step in 10.
    - docs/SOP_Build_and_Use.md is now a mirror of the Word file (images un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
2026-10-10 SOP: beginner-friendly pass on the latest revision
    Builds on the user's latest edits to docs/SOP_Build_and_Use.docx:
    - Add a short "How it works" overview and key terms (thigh = central,
    shank = peripheral, flashing, terminal, virtual environment, port).
    - Python setup: separate Windows and macOS/Linux command blocks with the
    activate step as a real command (it was hidden in a # note), and no
    inline "# ..." notes, which Windows Command Prompt passes as arguments
    and which break the self-tests. Same fix for the 7.1 commands.
    - How-tos: download the ZIP, open a terminal in the folder, reopen the
    environment next time, find the port, tell the GUI picked the board.
    - Point readers to t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
2026-10-13 Add GitHub Actions workflow to build and release KneeGoniometerGUI.exe
    Builds knee_gui.py into a single-file windowed exe with PyInstaller on a
    Windows runner (after running the self-test) and attaches it to a GitHub
    Release when a v* tag is pushed. Ignore PyInstaller build output and
    document the release/download flow in the README.
    Claude-Session: https://claude.ai/code/session_01W7CPhNYJSWLvHP1sa4PkcP
2026-10-13 SOP: use the released Windows exe for data collection
    Based on the user's latest SOP revision. Merged main first, which brings in
    the release workflow (.github/workflows/release.yml).
    - New 4.3 "Installing the GUI program (Windows)": download
    KneeGoniometerGUI.exe from the Releases page, keep it in a writable
    folder (recordings are saved next to it), get past the first-run
    SmartScreen warning, and replace the file to update.
    - The Python setup moves to 4.4 "Python version (optional)", for changing
    the GUI, the command-line tools, or macOS/Linux.
    - 7: start the GUI by double-clicking the exe; 7.1 marked Python-only;
    8: files are saved next to the exe; key terms and materials updated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
2026-10-13 Arduino Nano 33 BLE Rev2 Case for this project
2026-10-13 SOP final review; record the exe decision; wrap-up
    - SOP (user's final edits + review): developer material moved to the end
    as Appendix A (Python version) and Appendix B (releasing an updated GUI),
    so operators go straight from setup (4.1-4.3) to the checklist and
    session; cross-references updated. Clearer Python-version intro, a
    version line (v1.0, matches GUI v1.0.0), and "GUI program downloaded"
    added to the pre-session checklist.
    - DESIGN_DECISIONS: 7.6 Windows executable released on version tags;
    timeline rows for the handover docs and release v1.0.0.
    - HANDOVER: current state mentions the released exe and the final SOP;
    release steps point to SOP Appendix B.
    Co-Authored-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
2026-10-13 SOP: update to the author's final version
    Replace docs/SOP_Build_and_Use.docx with the author's final Word file
    (authorship line, how to tell which board is faulty, wording tweaks) and
    regenerate the Markdown mirror. HANDOVER notes the same faulty-board hint.
    Claude-Session: https://claude.ai/code/session_0168zQykpFCiWMnuLtZC4oyp
2026-10-13 Merge handover, design decisions and areas to explore into one document
    docs/Project_Handover.md (+ .docx, same name) replaces HANDOVER.md,
    DESIGN_DECISIONS.md and areas_to_explore.md: Part 1 handover summary,
    Part 2 design decisions, Part 3 research areas as Appendices A-D.
    Cross-references renumbered; stale notes on the case STL and strap
    mounting updated. build_docs.sh and README point to the new file.
    Claude-Session: https://claude.ai/code/session_01T5w3MNfAvZmU4ZjzVzMm8b
2026-10-13 Handover doc: apply review edits, add figures, trim §3 onward
    - Bring in the author's Word edits through §2.
    - Drop the Part 1/2/3 headings; §1.4 file map is now a table.
    - Add four figures (setup on the leg, data flow and packet, knee-angle
    geometry, session timeline), drawn as SVG and rendered to PNG.
    - Apply the same trimming to §3 onward and the appendices: remove
    commit-hash evidence lines and content repeated elsewhere.
    - build_docs.sh re-renders the figures when cairosvg is available.
    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
2026-10-13 Handover doc: second review round
    - Bring in the author's Word edits (shorter glossary, 'Design Decision'
    label, §4.1 wording) and apply the same style to the rest.
    - §3.1: explain that merging on the thigh board keeps both readings in
    step at 50 Hz.
    - Move the axis correction out of the design decisions into a maintainer
    note (it is a bug fix); renumber §4.
    - Drop bug history and appendix-only alternatives from decisions.
    - Remove the analysis-scripts open issue; describe them in §1.4.
    - Figure 1 caption: USB-toward-hip is a convention, not a requirement.
    - Figure 2: larger text, simpler wording.
    Claude-Session: https://clau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
2026-10-13 Handover doc: third review round
    - Bring in the author's Word edits: plain opening summaries without the
    'In short' label, '4. Sensor fusion' heading, §6 and §10 intros.
    - Fix the §4.2 heading that had merged into §4.1's text.
    - New Figure 3: how each board's filter blends gyroscope and
    accelerometer, with the bias and trust-weight steps; later figures
    renumbered.
    - Figure 2: 50 Hz labels; clearer thigh-board and PC steps.
    - Figure 5 (session timeline): larger text.
    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
2026-10-13 Handover doc: fourth review round
    - Bring in the author's Word edits: About paragraph removed, wording in
    §3 and §5.5, §9 as one 'Preliminary Stationary Testing' section,
    Windows-build decision and timeline removed.
    - §4: explain at a high level how the Mahony filter works (follow the
    rotation, compare with gravity, correct).
    - Figure 3 redrawn as the filter's three-step loop; magnetometer removed.
    - §8 rewritten as a list of software features.
    - All figure text at least 14 px.
    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
2026-10-14 Handover doc: audience review fixes
    - Version line; 'Where to start' table by reader role.
    - §1.4 note on which copy to edit; new §1.5 Handover logistics
    (prototype location, repository hand-over, contact).
    - Key terms moved after §1 so the summary comes first.
    - Wording: consistent thigh/shank naming in §1 and the LED table,
    sagittal/flexion explained in §2, formula dropped from §5.4, single-
    placement note on the 45/90 rig result, how to identify the faulty
    board, missing full stop.
    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
2026-10-14 Handover doc: author's final adjustments
    Version line, Appendix A.7 heading, and Appendix C wording (board name,
    Bluetooth dongle note).
    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
2026-10-29 Adding .step case cad file
